eee62/pbthing/out/sim/render/final_s30_events_all_steps.png

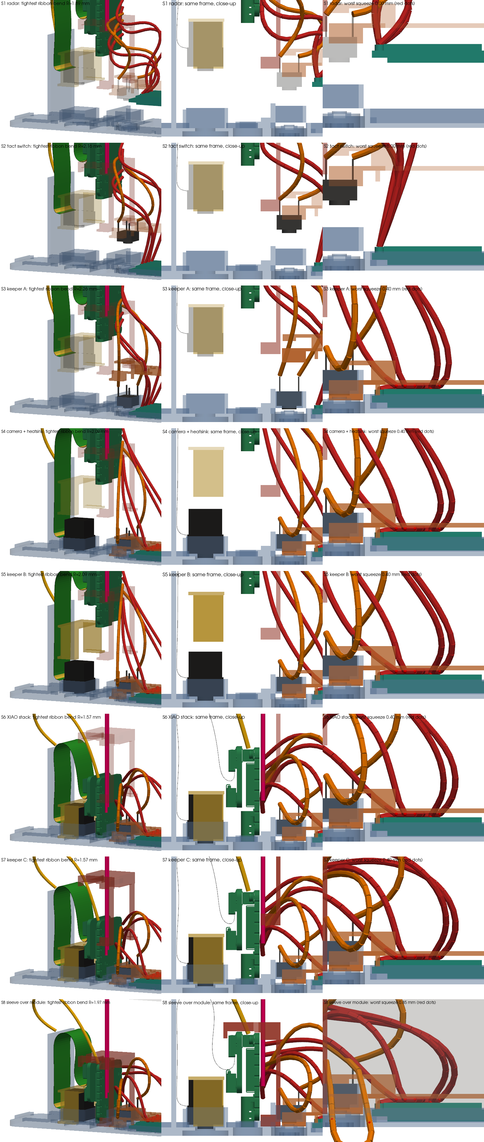
out/sim/render/final_s30_events_all_steps.png
