eee62/pbthing/out/sim/render/A2_events_all_steps.png

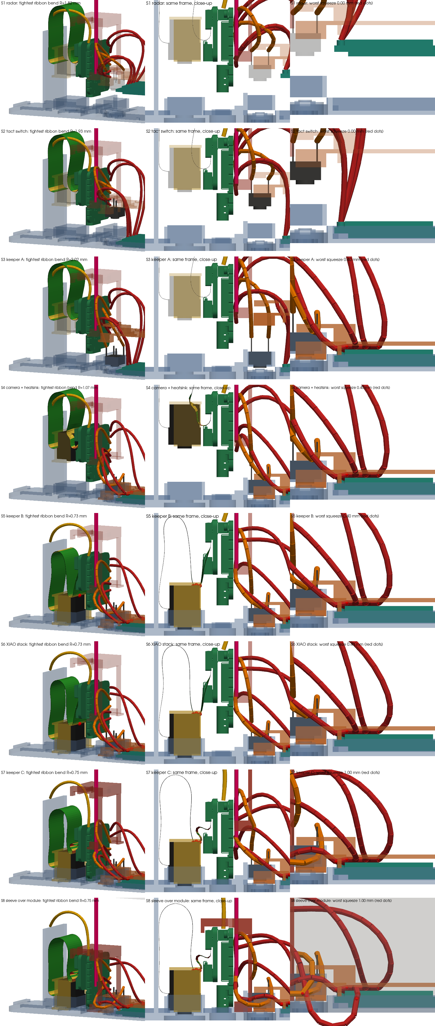
out/sim/render/A2_events_all_steps.png
