eee62/pbthing/out/img/bottom.png

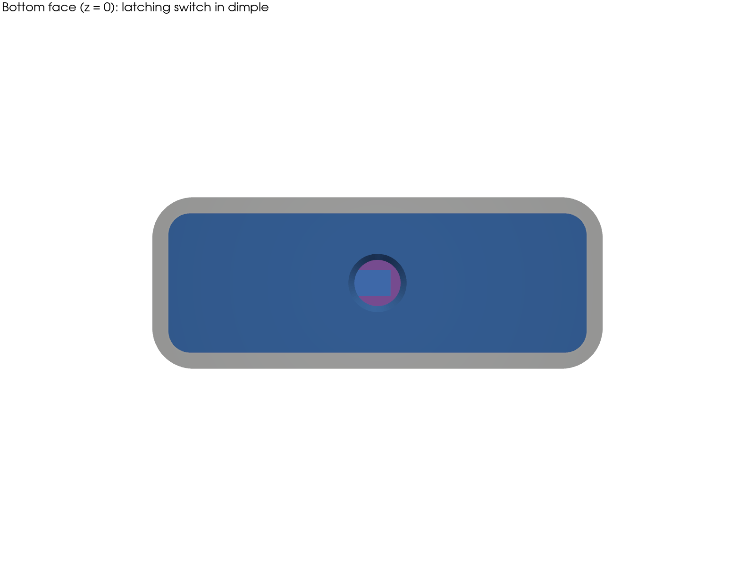
out/img/bottom.png
