eee62/pbthing/out/img/exploded.png

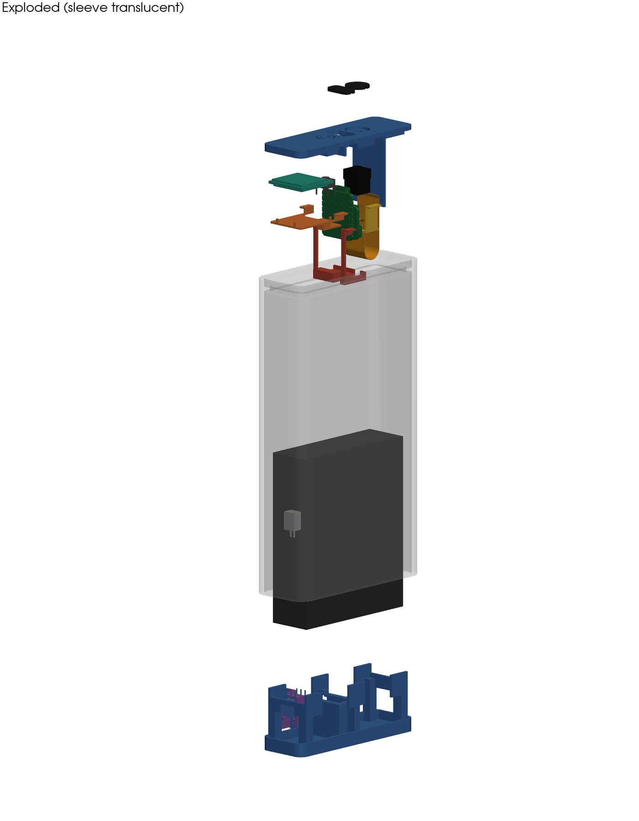
out/img/exploded.png
