eee62/pbthing/out/img/front.png

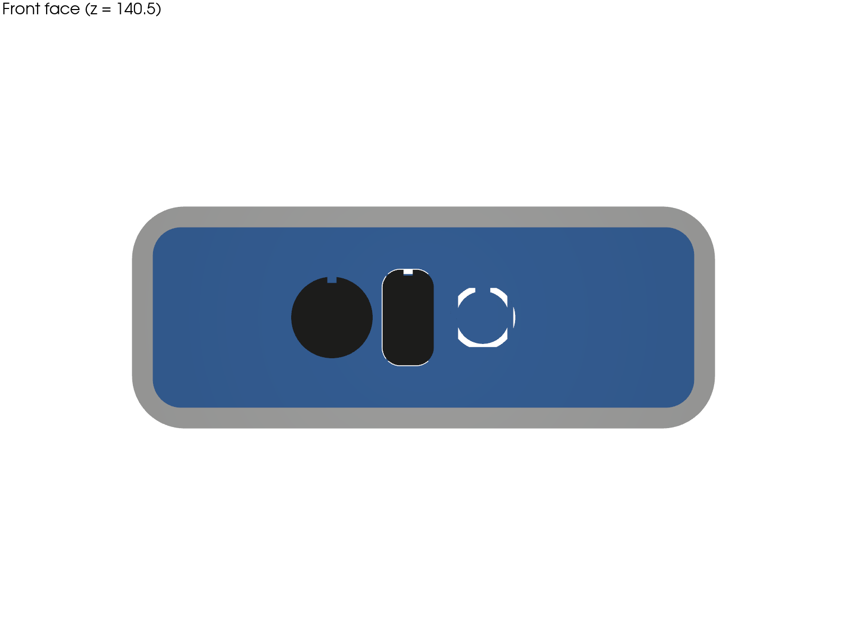
out/img/front.png
