eee62/pbthing/out/img/front_caps_off.png

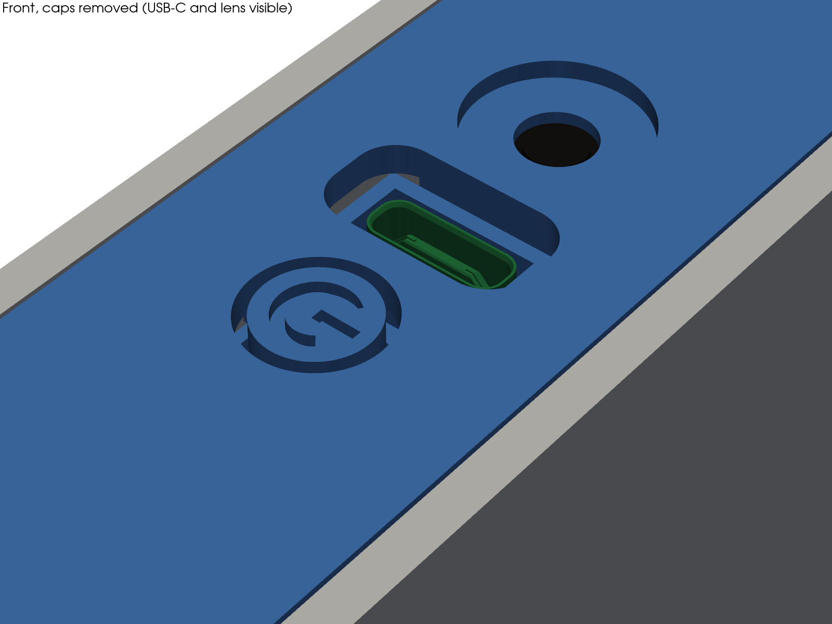
out/img/front_caps_off.png
