eee62/pbthing/out/img/insert_from_below.png

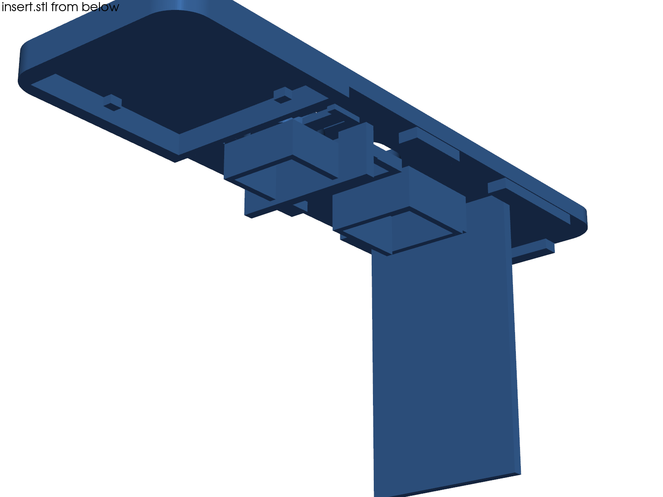
out/img/insert_from_below.png
