eee62/pbthing/out/img/section_full_x14.7.png

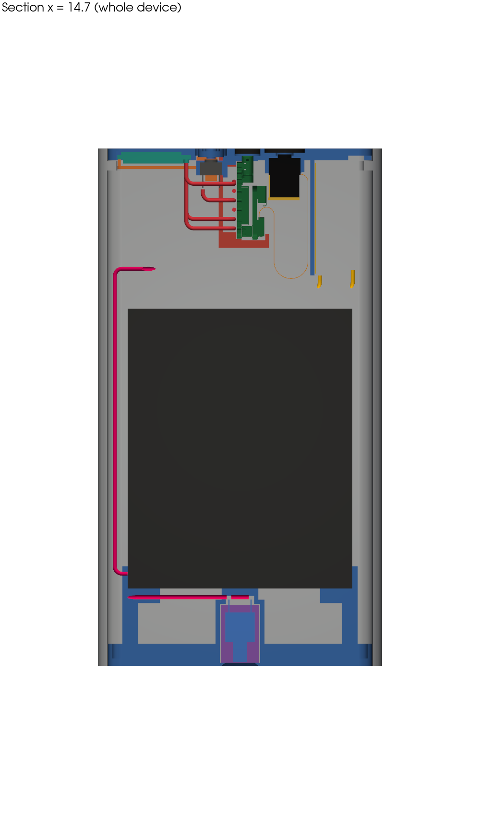
out/img/section_full_x14.7.png
