eee62/pbthing/out/img/section_top_x14.7.png

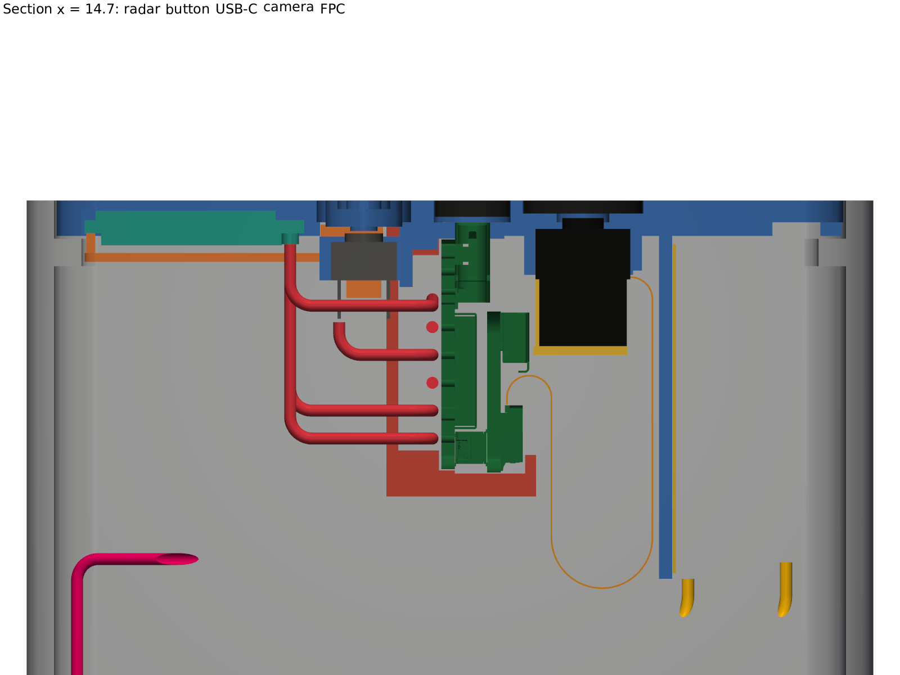
out/img/section_top_x14.7.png
