eee62/pbthing/out/img/section_y38.6_switch.png

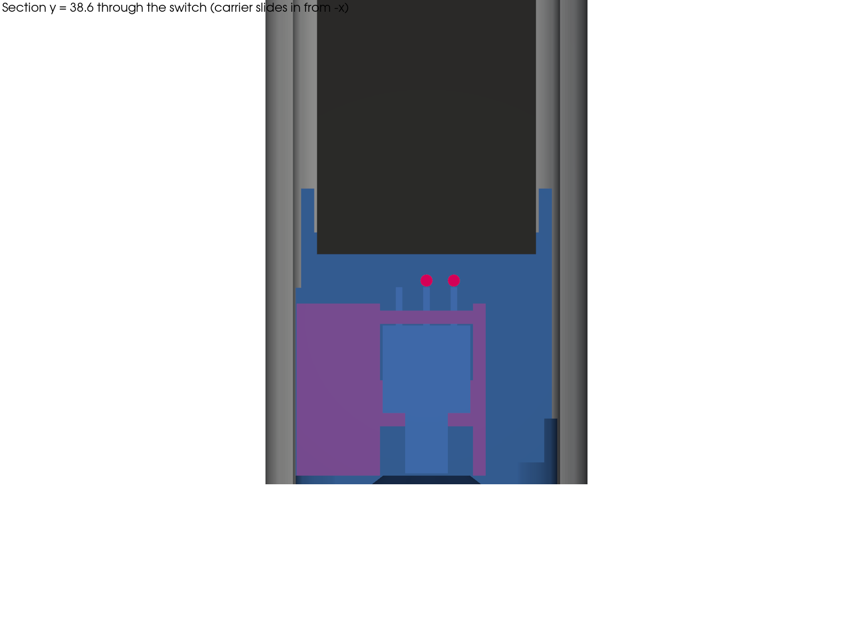
out/img/section_y38.6_switch.png
