eee62/pbthing/out/img/wires_all.png

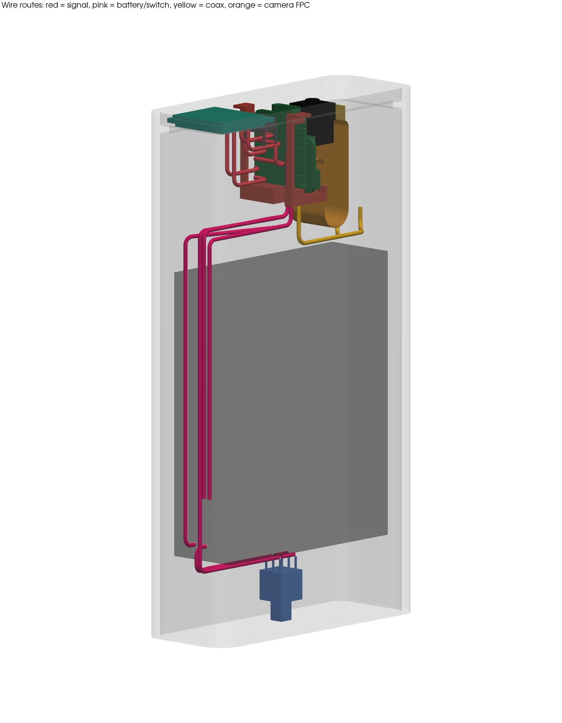
out/img/wires_all.png
