eee62/pbthing/out/img/wires_top.png

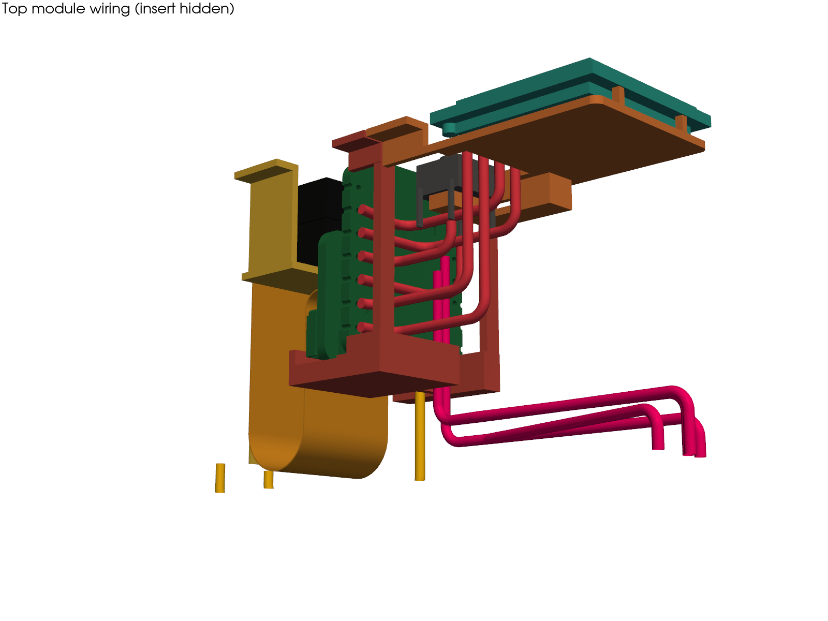
out/img/wires_top.png
