eee62/pbthing/out/img/wires_top_side.png

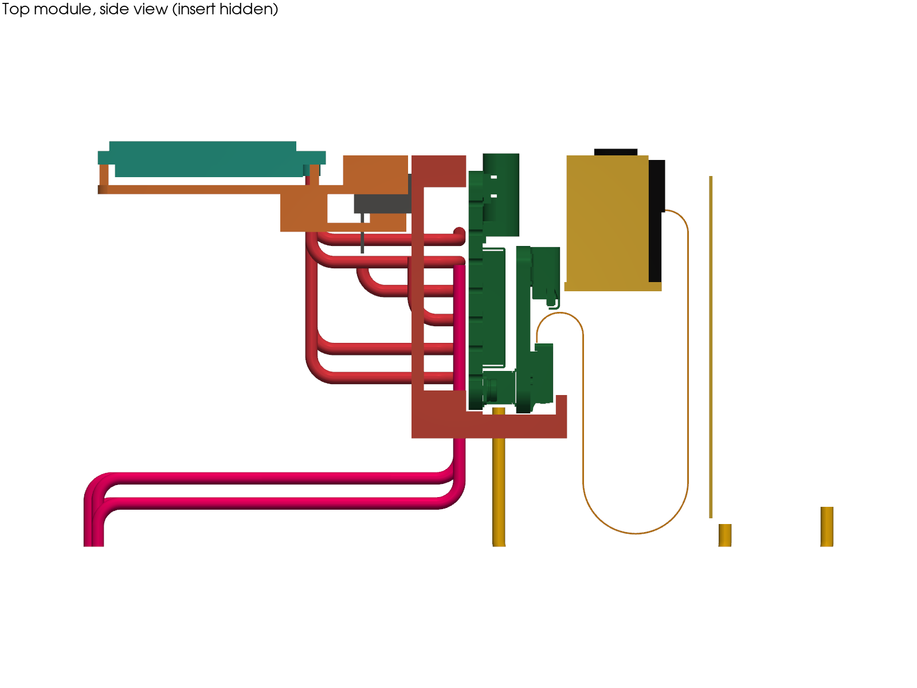
out/img/wires_top_side.png
