eee62/pbthing/out/sim/render/A2_S2_tact_switch.png

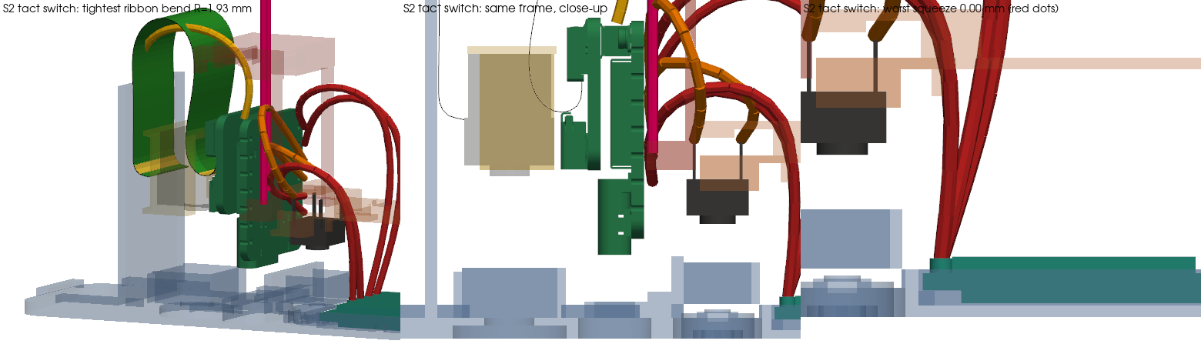
out/sim/render/A2_S2_tact_switch.png
