eee62/pbthing/out/sim/render/A2_S3_keeper_A.png

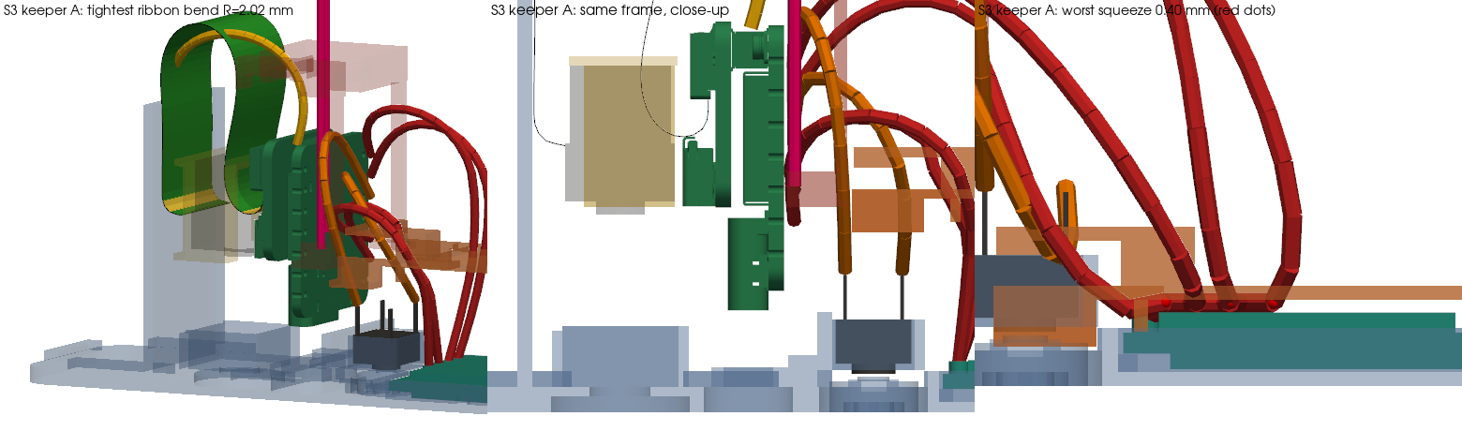
out/sim/render/A2_S3_keeper_A.png
