eee62/pbthing/out/sim/render/A2_S4_camera__heatsink.png

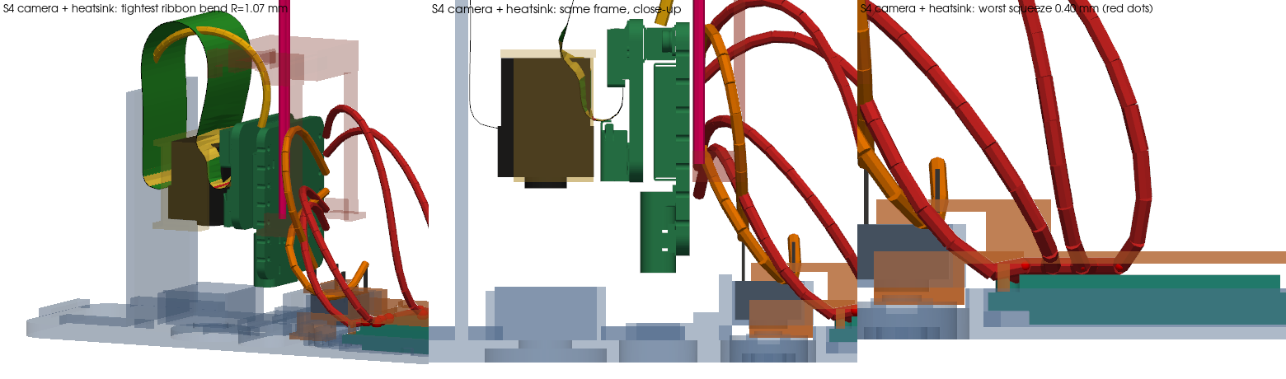
out/sim/render/A2_S4_camera__heatsink.png
