eee62/pbthing/out/sim/render/A2_S5_keeper_B.png

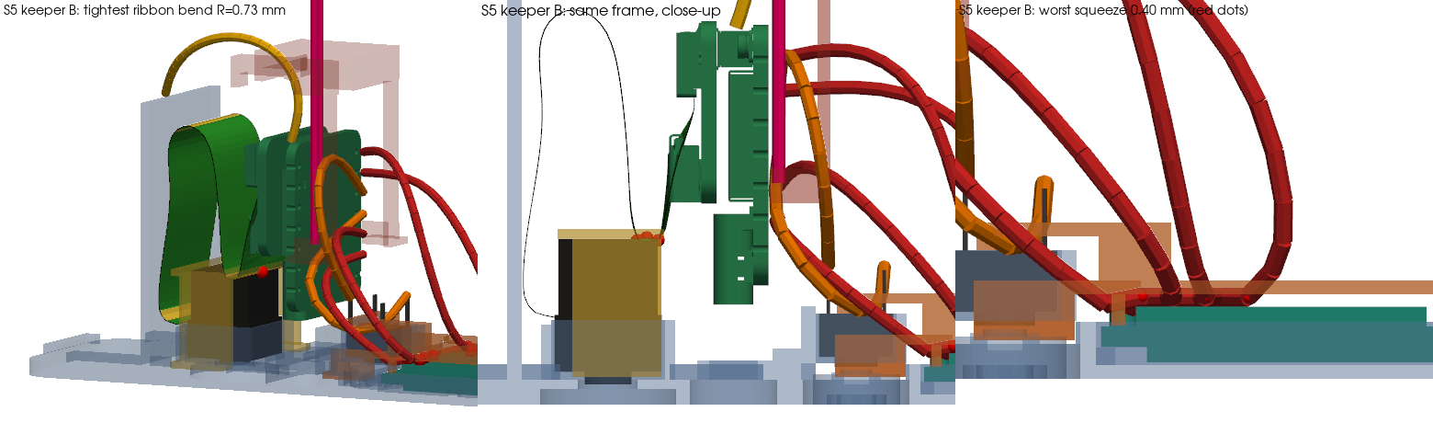
out/sim/render/A2_S5_keeper_B.png
