eee62/pbthing/out/sim/render/A2_S7_keeper_C.png

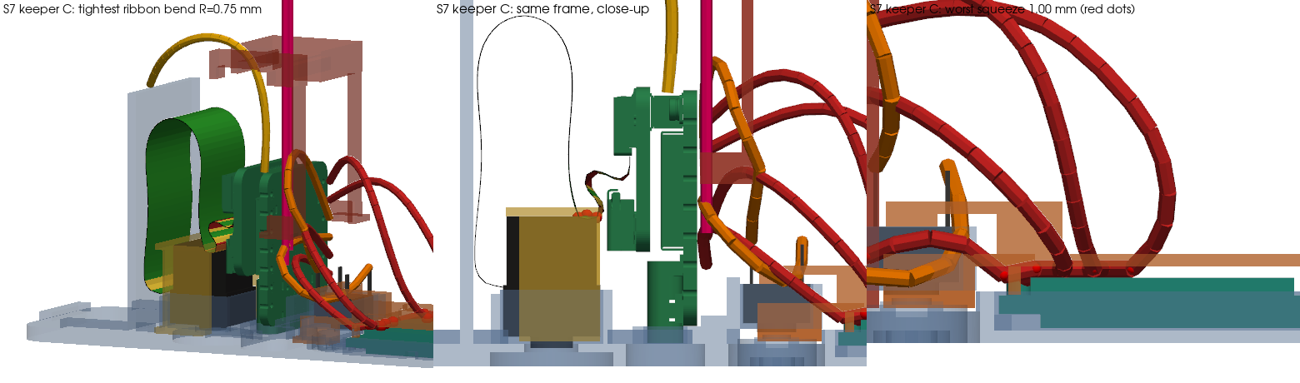
out/sim/render/A2_S7_keeper_C.png
