eee62/pbthing/out/sim/render/A2_S8_sleeve_over_module.png

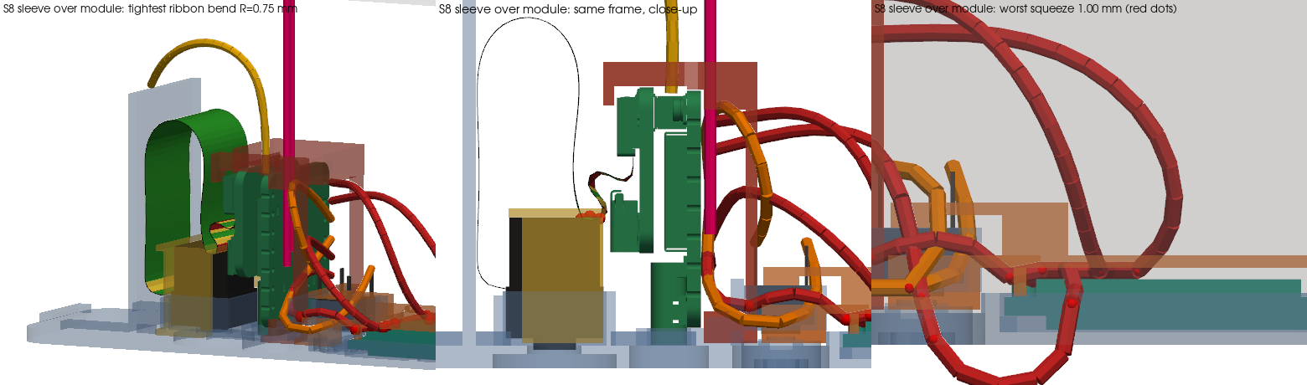
out/sim/render/A2_S8_sleeve_over_module.png
