eee62/pbthing/out/sim/render/fail_hold6_S1_radar.png

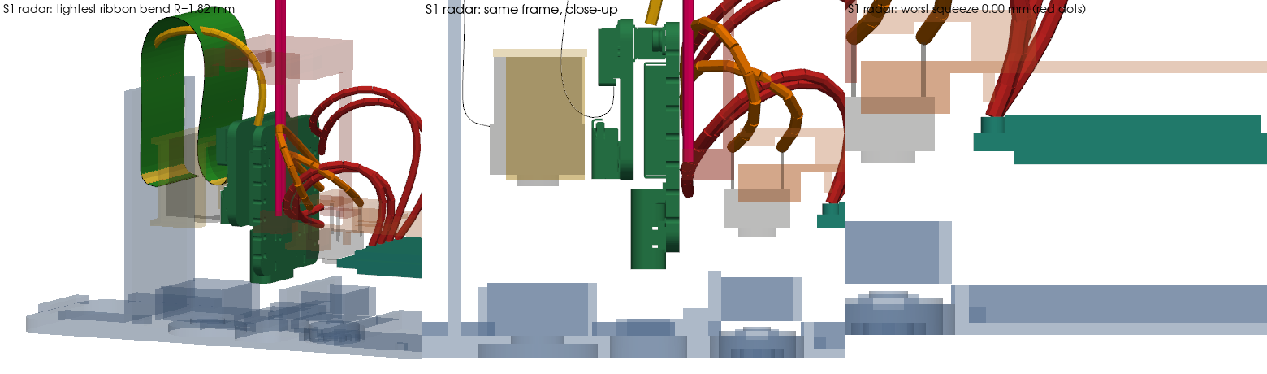
out/sim/render/fail_hold6_S1_radar.png
