eee62/pbthing/out/sim/render/fail_hold6_S3_keeper_A.png

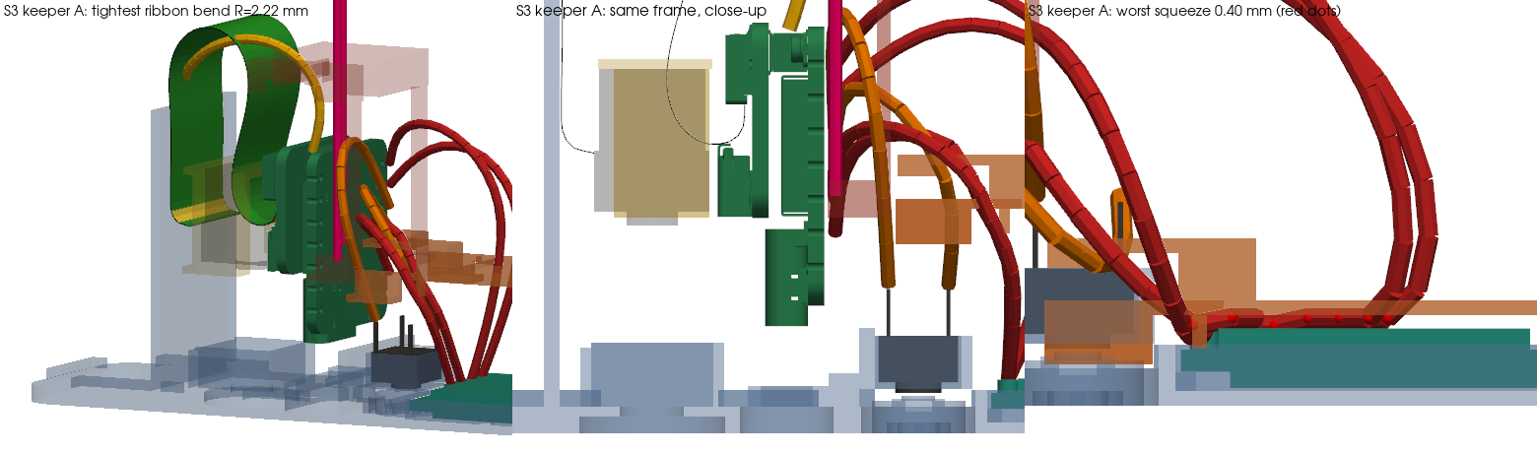
out/sim/render/fail_hold6_S3_keeper_A.png
