eee62/pbthing/out/sim/render/fail_hold6_S4_camera__heatsink.png

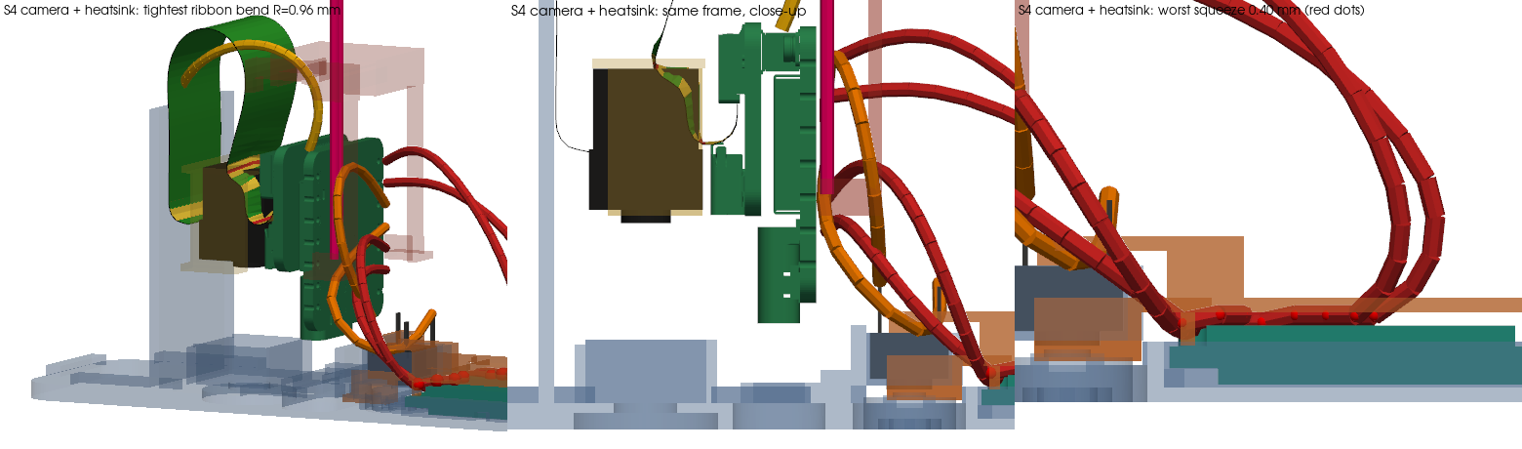
out/sim/render/fail_hold6_S4_camera__heatsink.png
