eee62/pbthing/out/sim/render/fail_hold6_S7_keeper_C.png

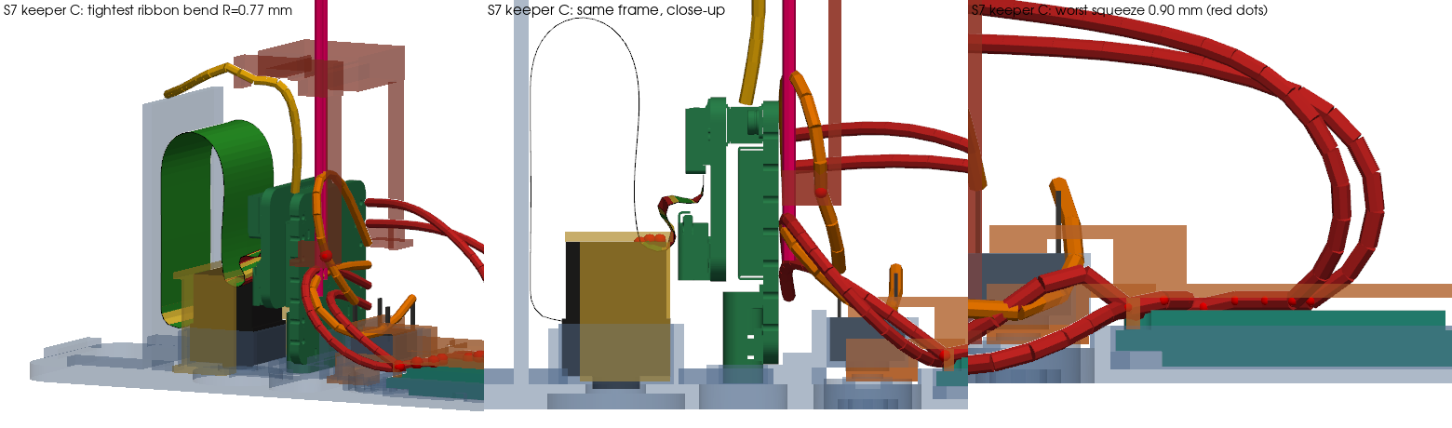
out/sim/render/fail_hold6_S7_keeper_C.png
