eee62/pbthing/out/sim/render/final_dress_S1_radar.png

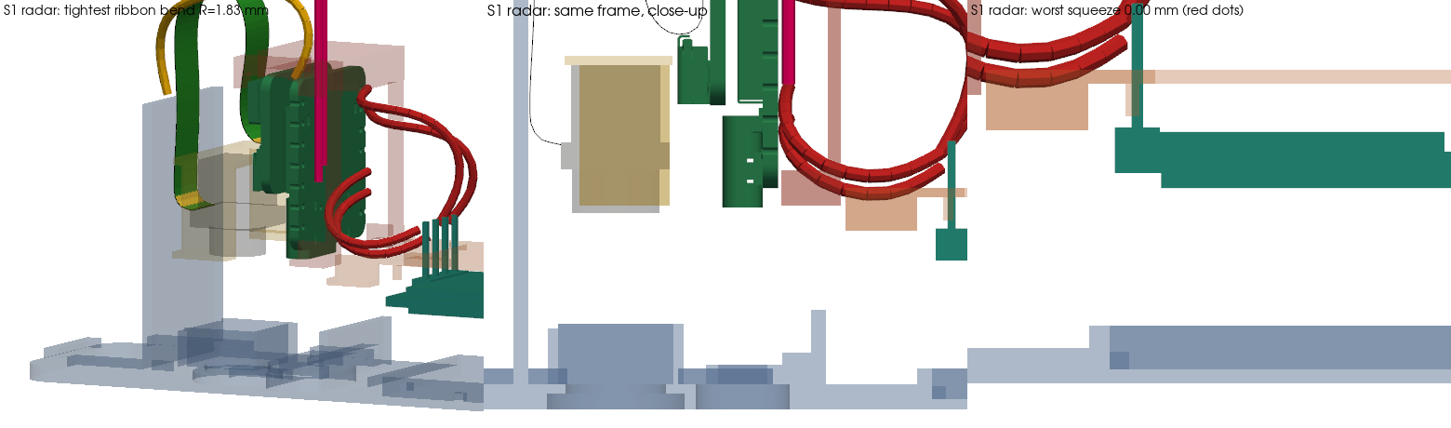
out/sim/render/final_dress_S1_radar.png
