eee62/pbthing/out/sim/render/final_dress_S2_tact_switch.png

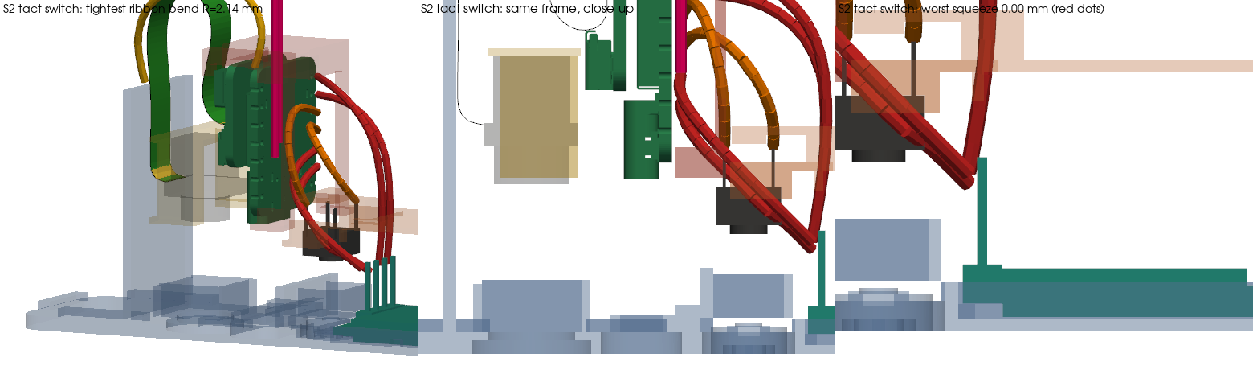
out/sim/render/final_dress_S2_tact_switch.png
