eee62/pbthing/out/sim/render/final_dress_S3_keeper_A.png

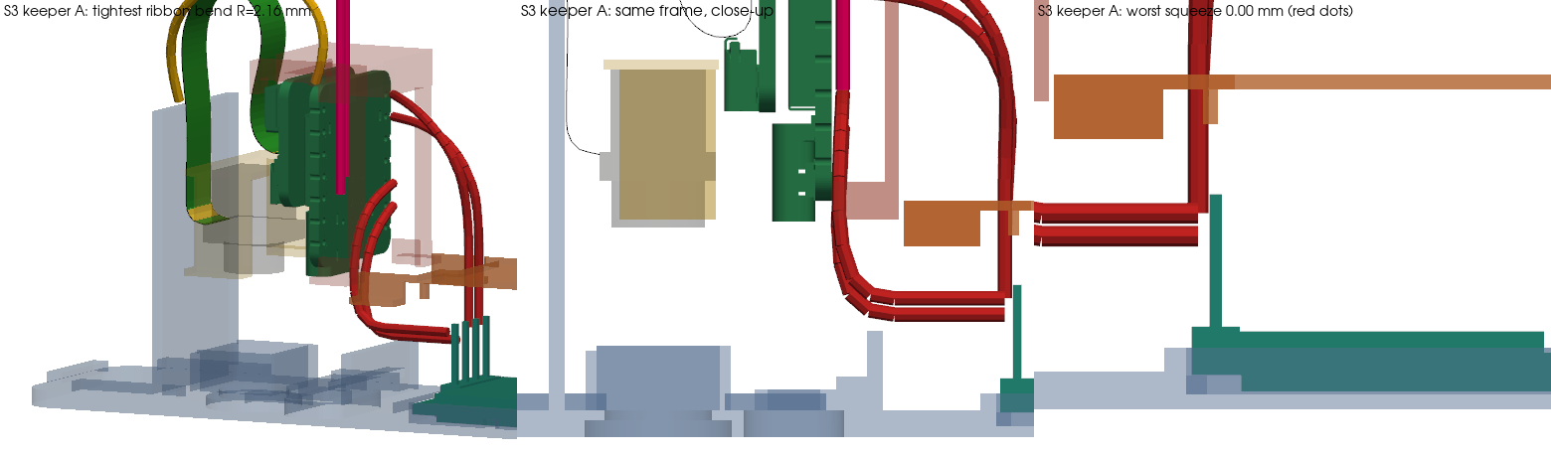
out/sim/render/final_dress_S3_keeper_A.png
