eee62/pbthing/out/sim/render/final_dress_S4_camera__heatsink.png

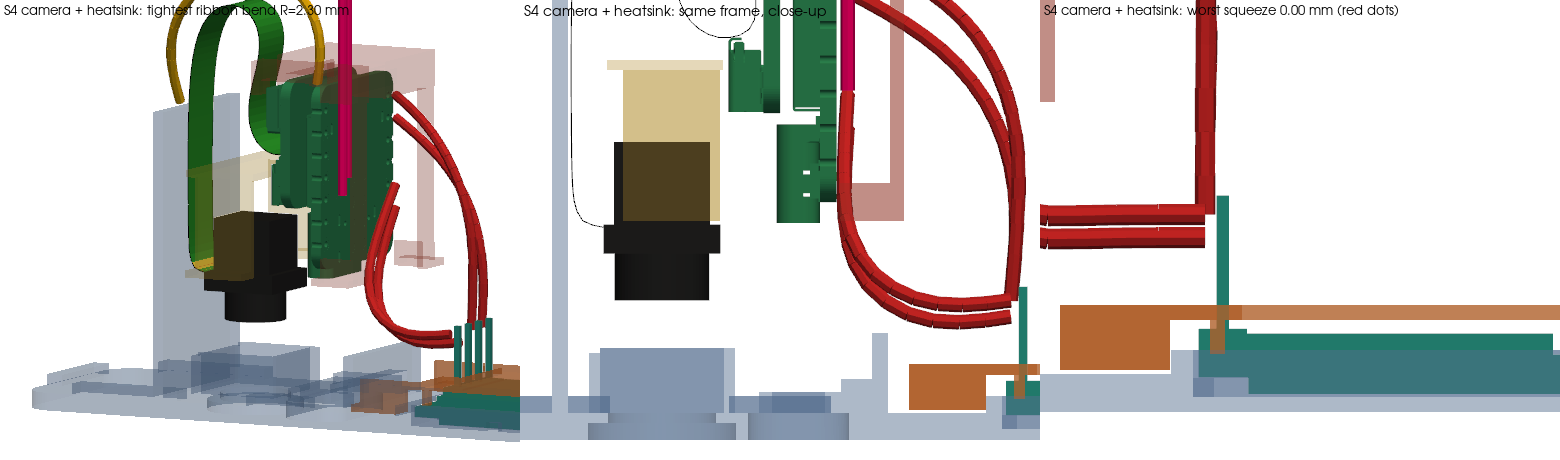
out/sim/render/final_dress_S4_camera__heatsink.png
