eee62/pbthing/out/sim/render/final_dress_S5_keeper_B.png

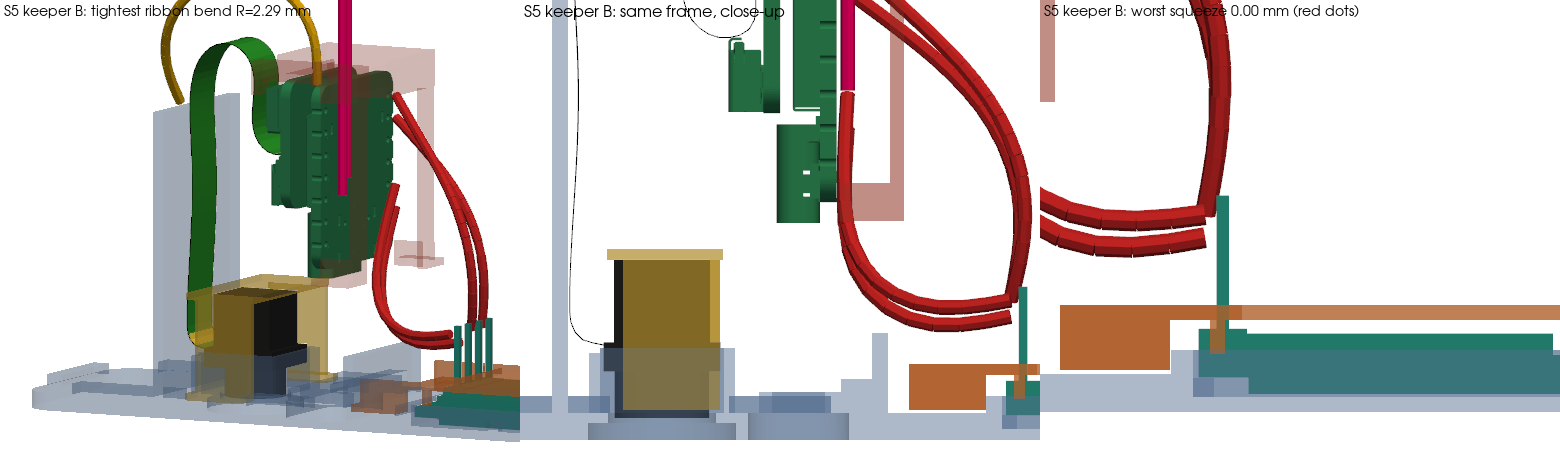
out/sim/render/final_dress_S5_keeper_B.png
