eee62/pbthing/out/sim/render/final_dress_S6_XIAO_stack.png

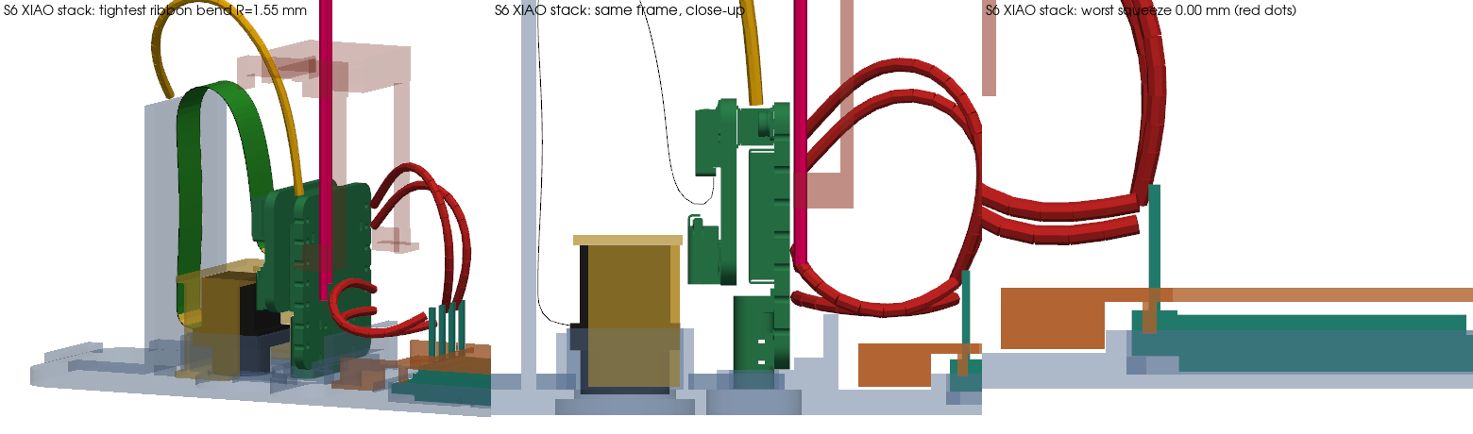
out/sim/render/final_dress_S6_XIAO_stack.png
