eee62/pbthing/out/sim/render/final_s30_S1_radar.png

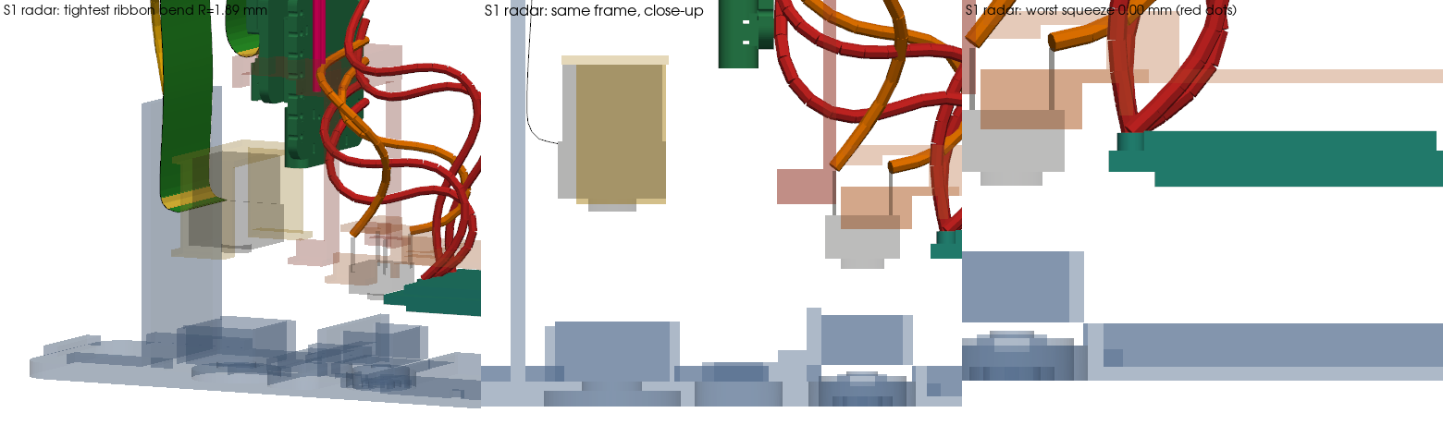
out/sim/render/final_s30_S1_radar.png
