eee62/pbthing/out/sim/render/final_s30_S3_keeper_A.png

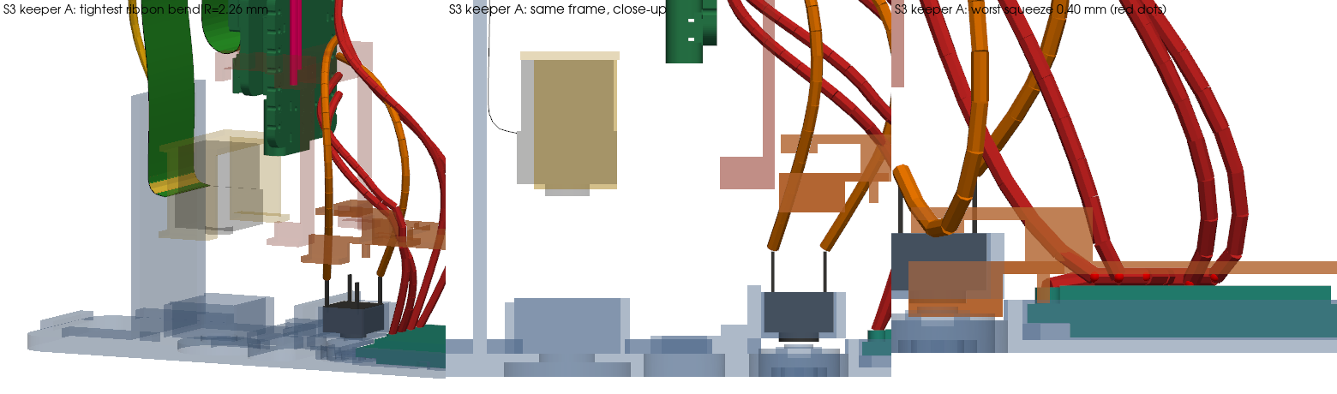
out/sim/render/final_s30_S3_keeper_A.png
