eee62/pbthing/out/sim/render/final_s30_S4_camera__heatsink.png

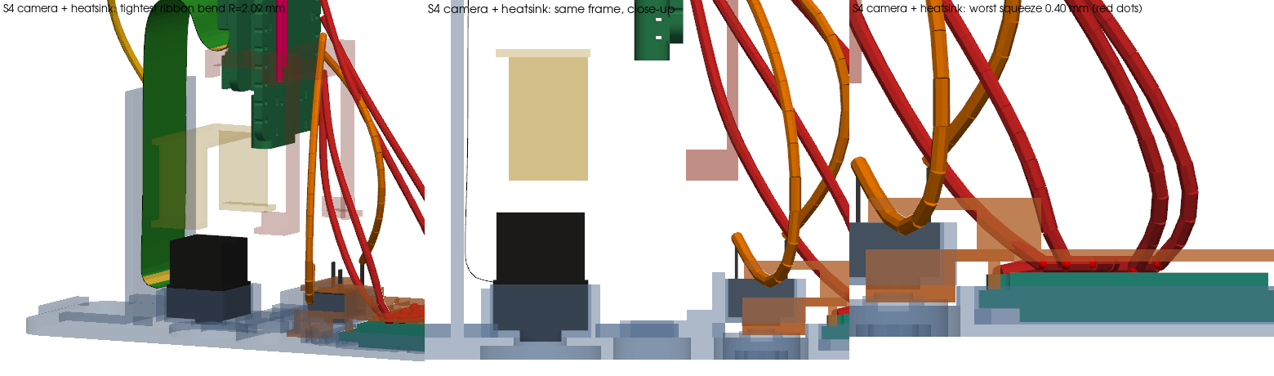
out/sim/render/final_s30_S4_camera__heatsink.png
