eee62/pbthing/out/sim/render/final_s30_S7_keeper_C.png

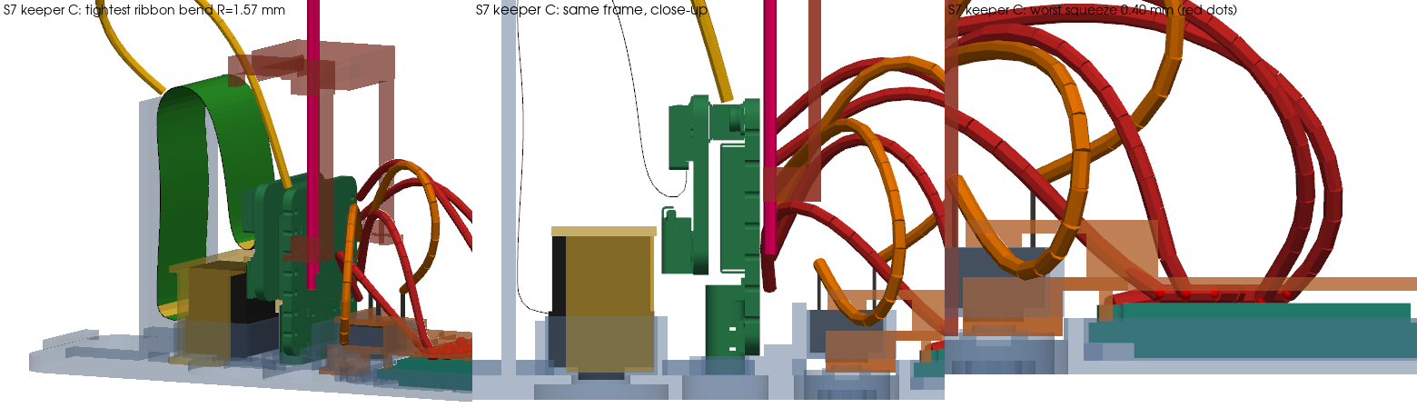
out/sim/render/final_s30_S7_keeper_C.png
