eee62/pbthing/out/sim/render/final_s30_S8_sleeve_over_module.png

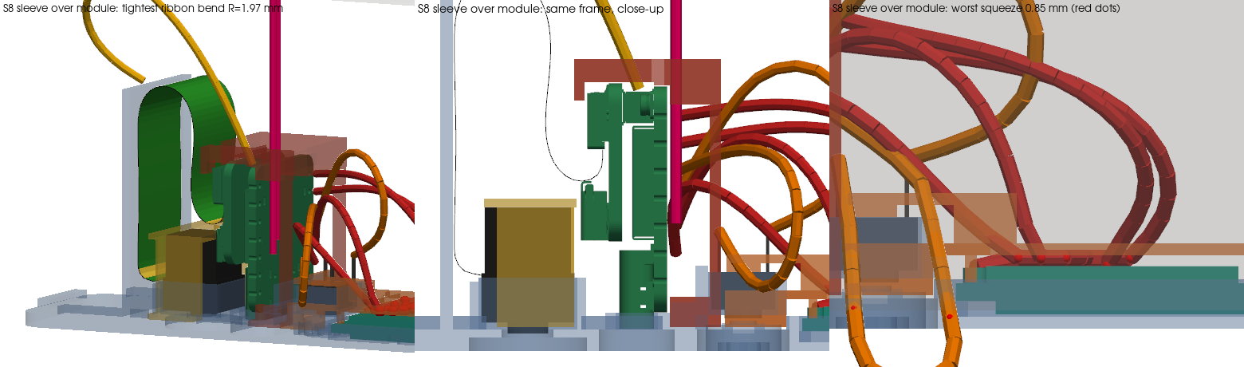
out/sim/render/final_s30_S8_sleeve_over_module.png
