eee62/pbthing/out/sim/render/radar_all_cases.png

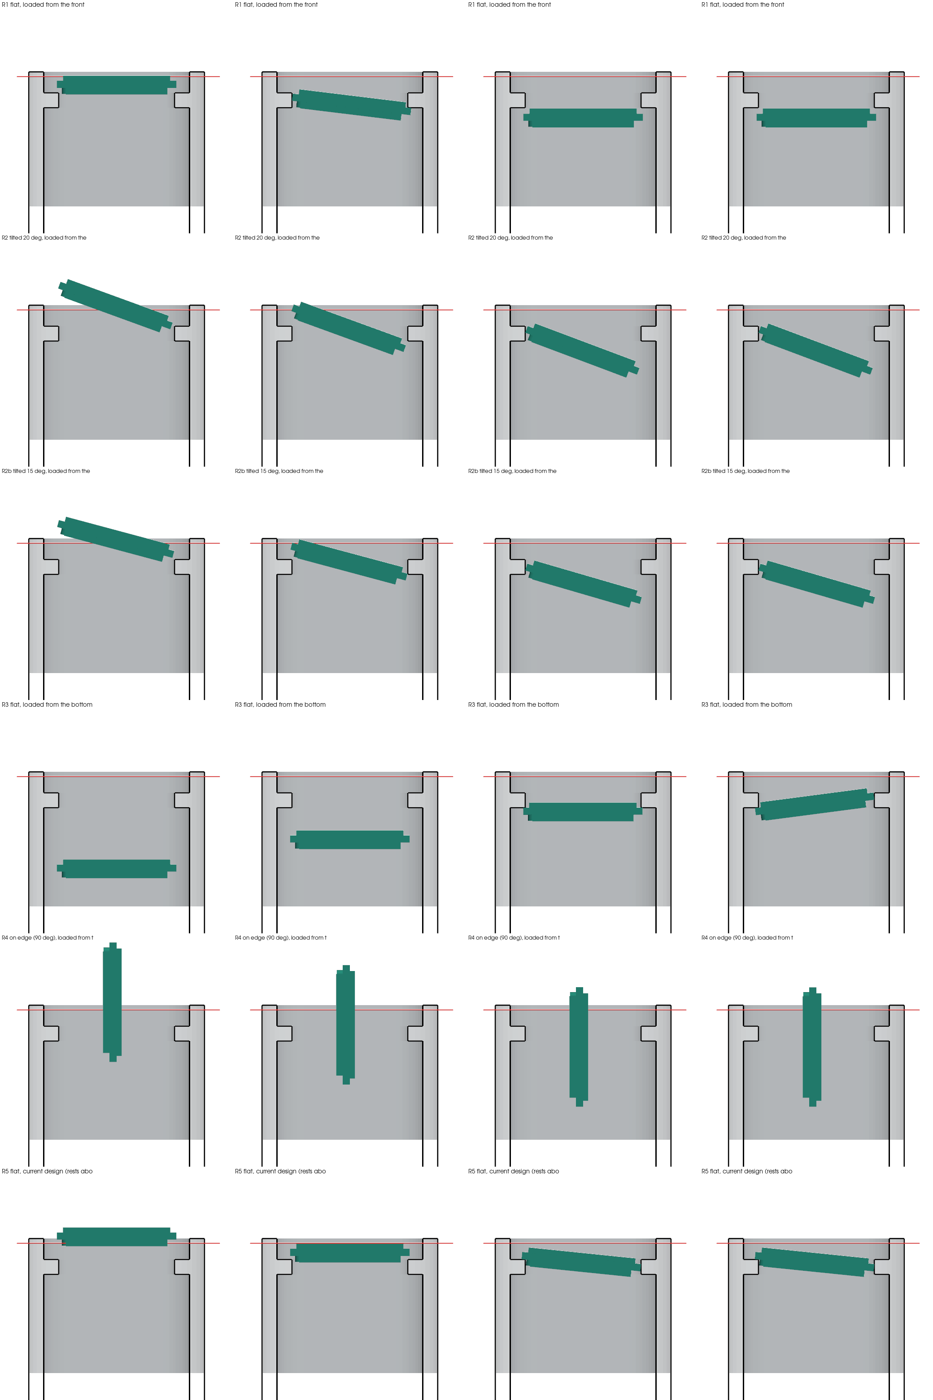
out/sim/render/radar_all_cases.png
