eee62/pbthing/out/sim/render/radar_R1.png

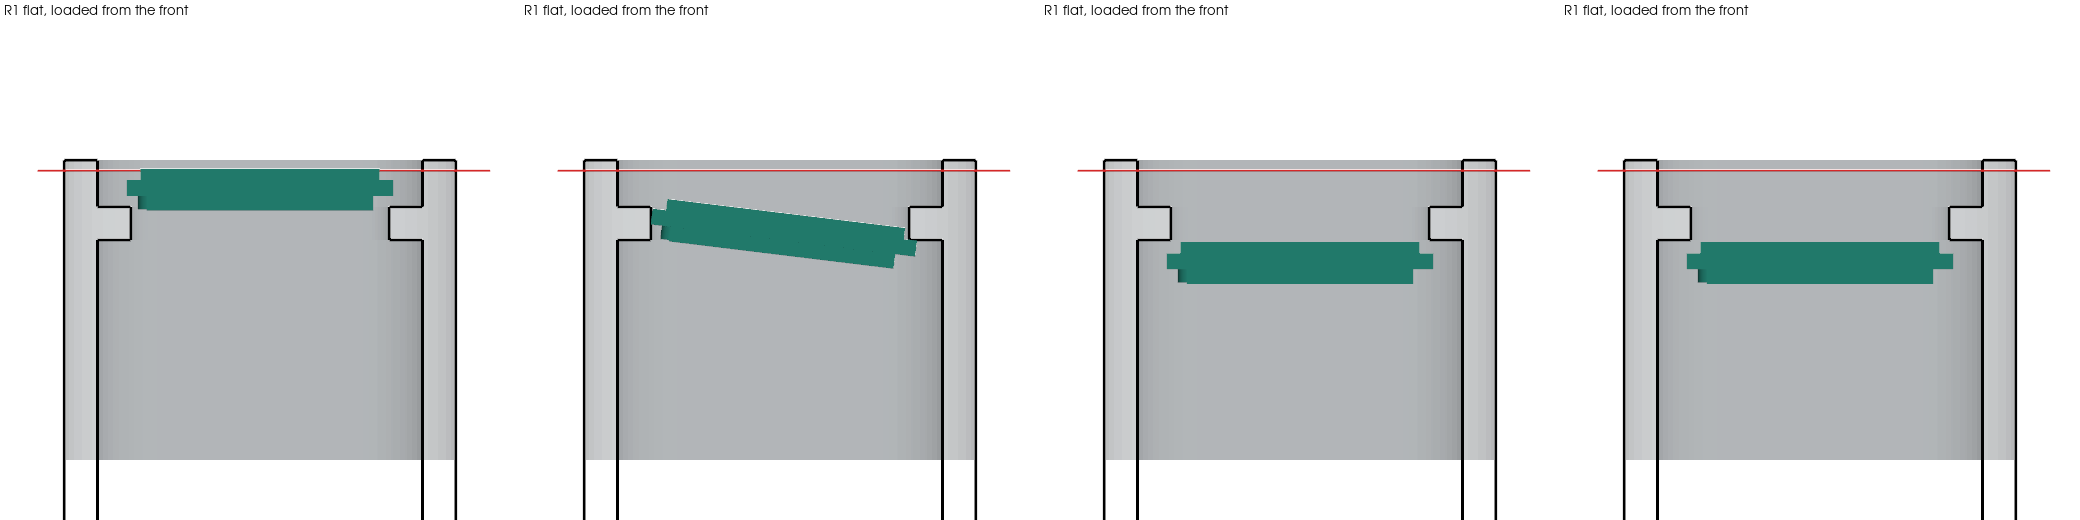
out/sim/render/radar_R1.png
