eee62/pbthing/out/sim/render/radar_R4.png

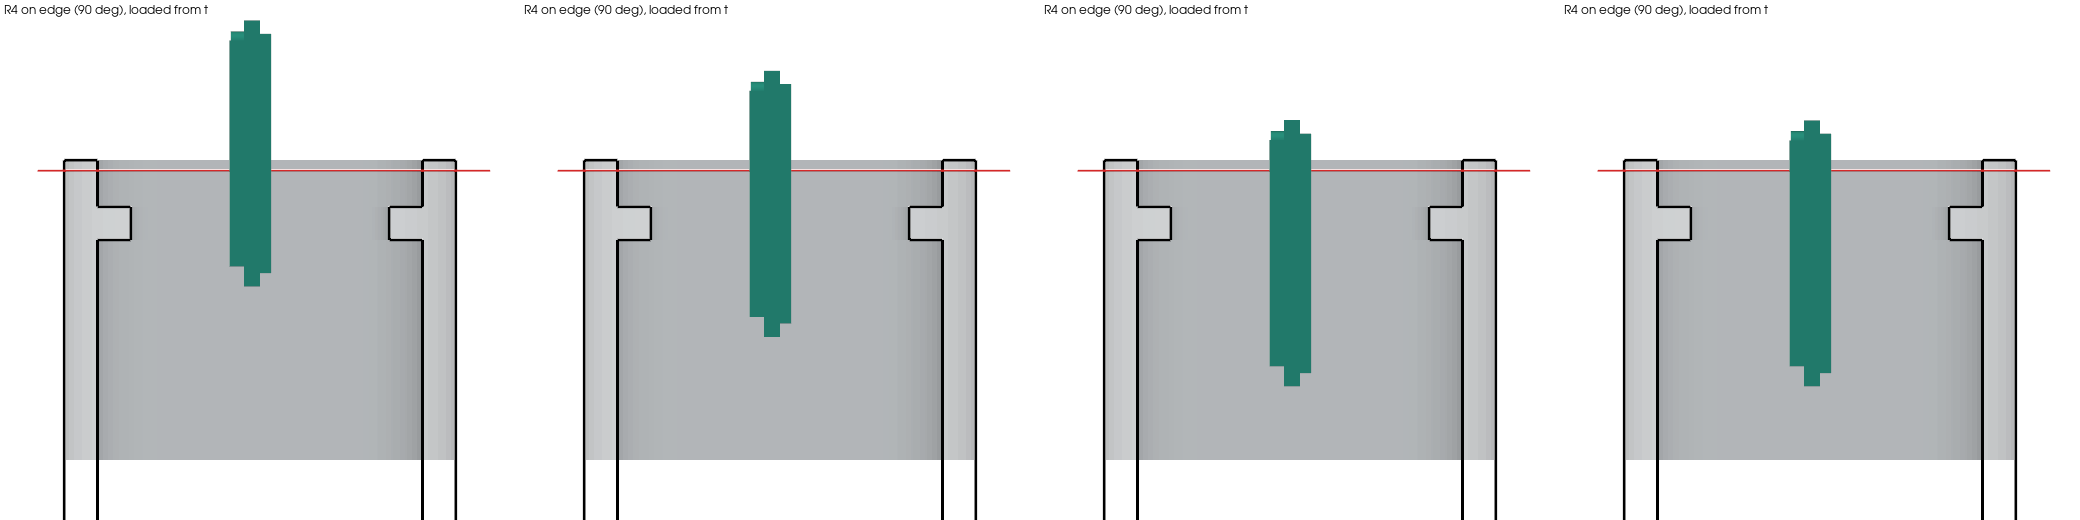
out/sim/render/radar_R4.png
