eee62/pbthing/inputs/XIAO_ESP32S3_ExpBoard_v1.0_bot.dxf

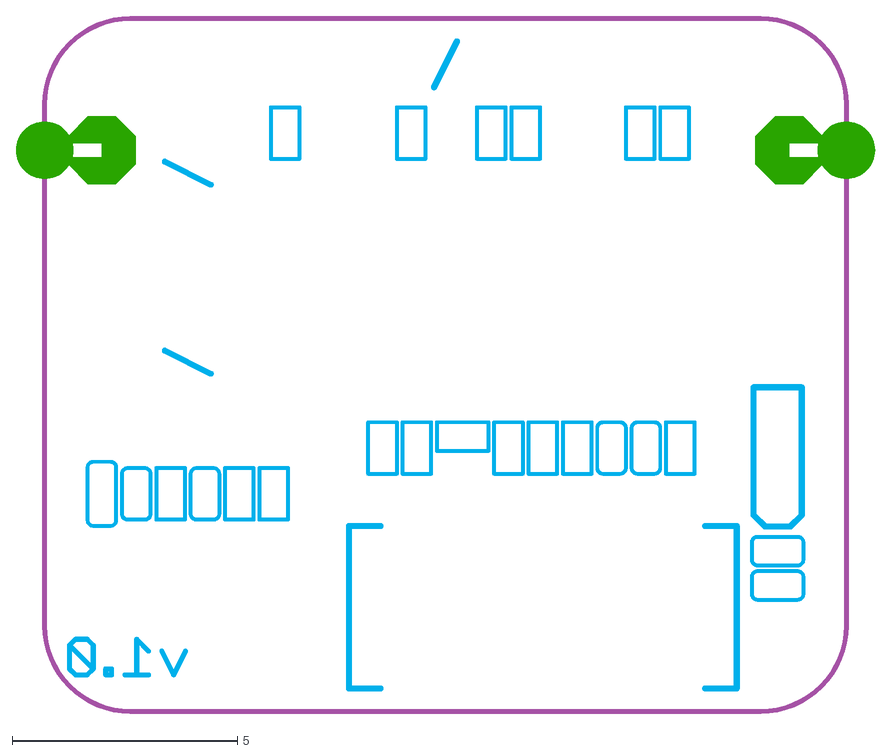
[picture p41: CAD file, 2026-11-05]
inputs/XIAO_ESP32S3_ExpBoard_v1.0_bot.dxf
19.0 x 15.5
