eee62/pbthing/out/step/keeper_c.step

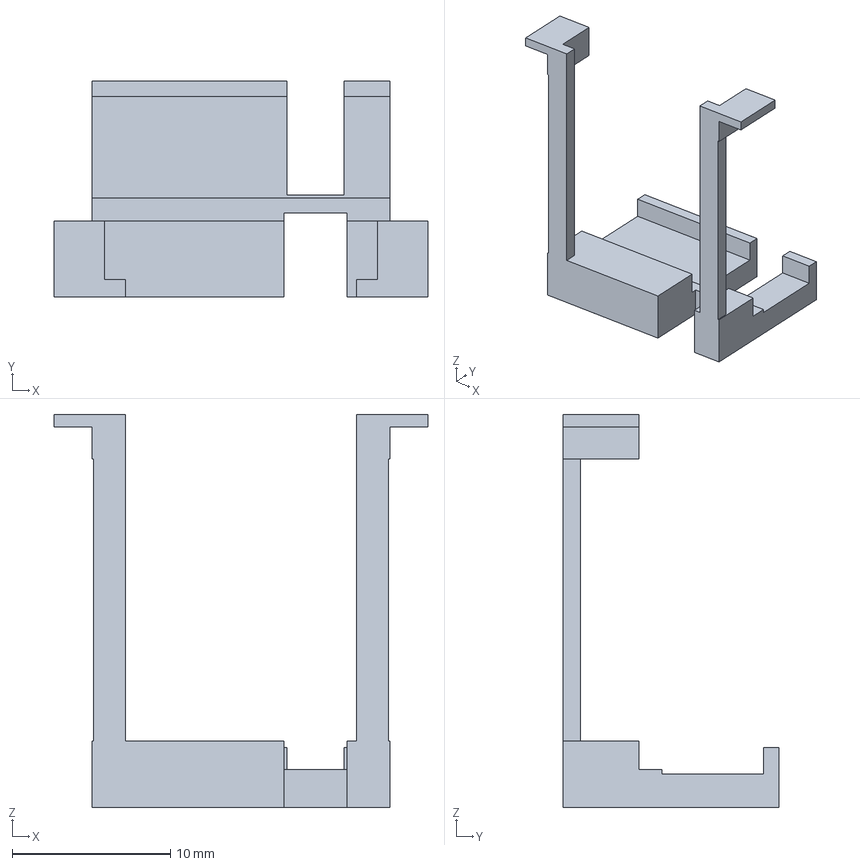
[picture p42: CAD file, 2026-11-08]
out/step/keeper_c.step
23.6 x 13.7 x 24.8 mm
