eee62/pbthing/out/stl/coupon.stl

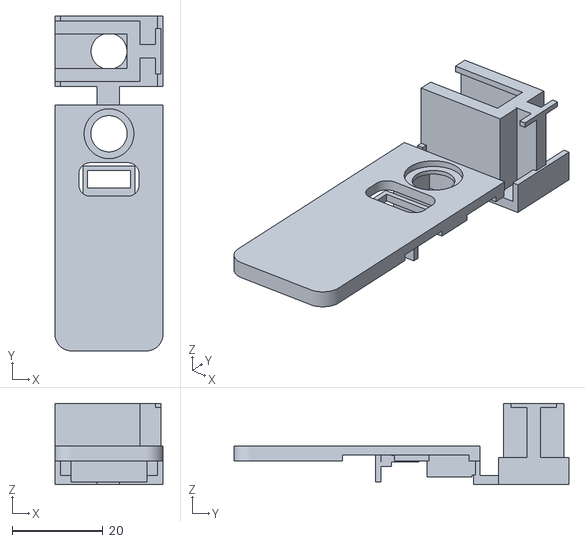
[picture p43: CAD file, 2026-11-08]
out/stl/coupon.stl
23.9 x 74.0 x 18.0
