eee62/pbthing/out/stl/tray_parts/keeper_a.stl

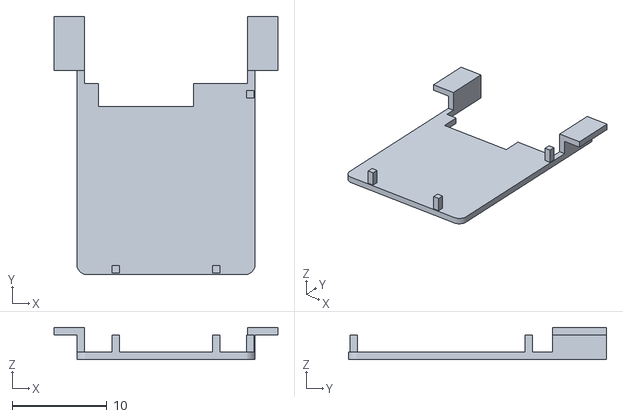
[picture p44: CAD file, 2026-11-08]
out/stl/tray_parts/keeper_a.stl
23.6 x 27.2 x 3.40
