eee62/pbthing/inputs/zen_v7_sleeve.stl

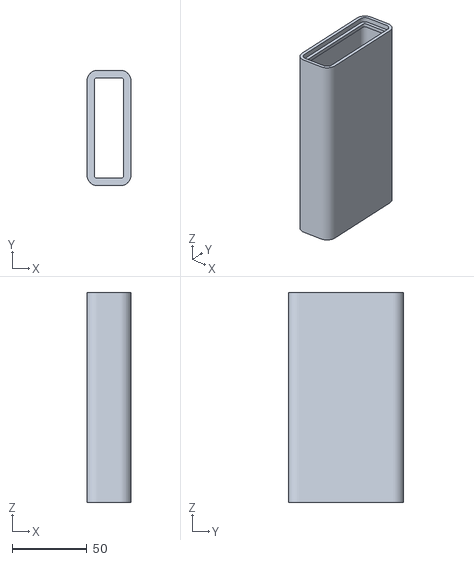
[picture p45: CAD file, 2026-11-05]
inputs/zen_v7_sleeve.stl
29.4 x 77.2 x 140.5
