eee62/pbthing/out/stl/tray.stl

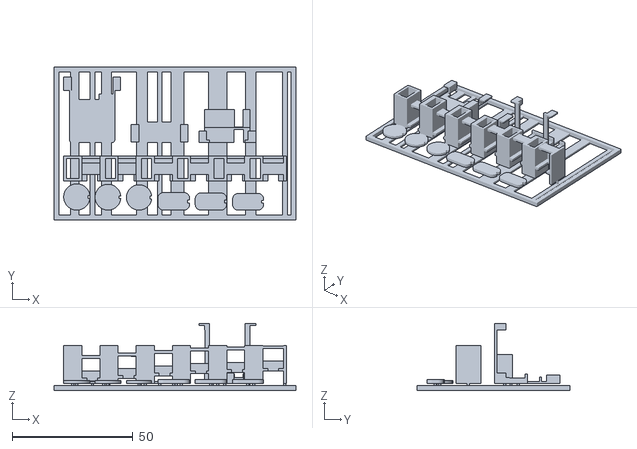
[picture p46: CAD file, 2026-11-08]
out/stl/tray.stl
100.2 x 63.2 x 27.8
