eee62/pbthing/out/stl/tray_parts/usb_cover_C.stl

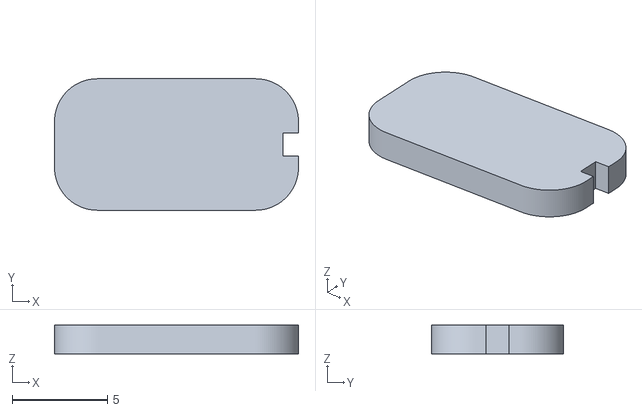
[picture p47: CAD file, 2026-11-07]
out/stl/tray_parts/usb_cover_C.stl
12.8 x 6.90 x 1.50
