eee62/pbthing/inputs/XIAO_ESP32S3_ExpBoard_v1.0_top.dxf

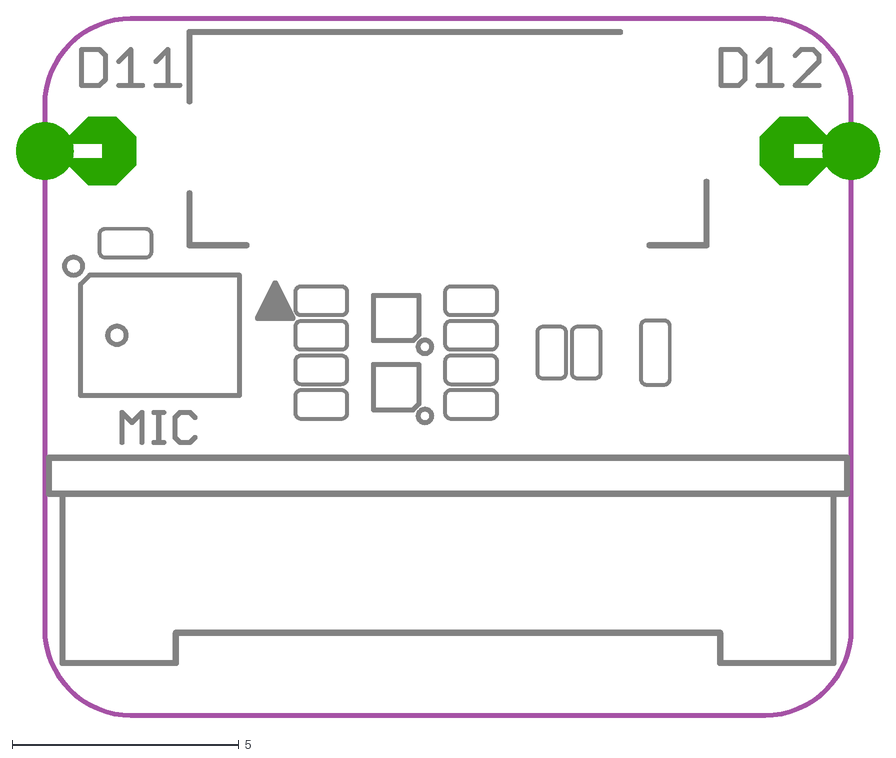
[picture p48: CAD file, 2026-11-05]
inputs/XIAO_ESP32S3_ExpBoard_v1.0_top.dxf
19.0 x 15.5
