eee62/pbthing/out/step/keeper_b.step

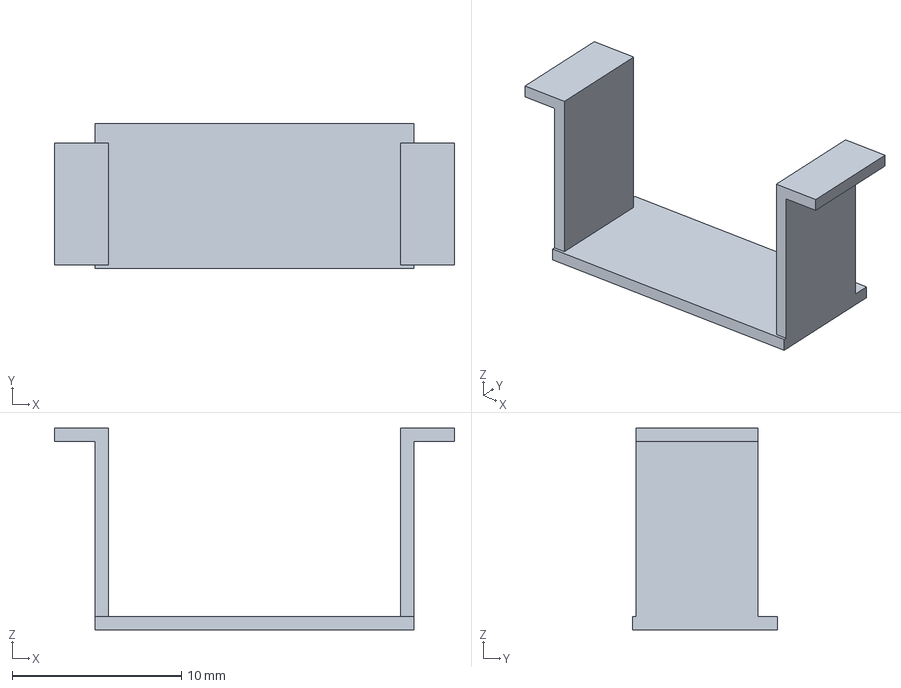
[picture p49: CAD file, 2026-11-08]
out/step/keeper_b.step
23.6 x 8.55 x 11.9 mm
