eee62/pbthing/out/stl/tray_parts/usb_cover_A.stl

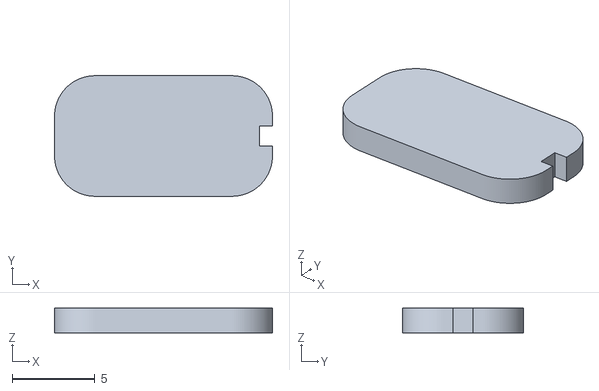
[picture p50: CAD file, 2026-11-07]
out/stl/tray_parts/usb_cover_A.stl
13.2 x 7.30 x 1.50
