eee62/pbthing/out/step/plug.step

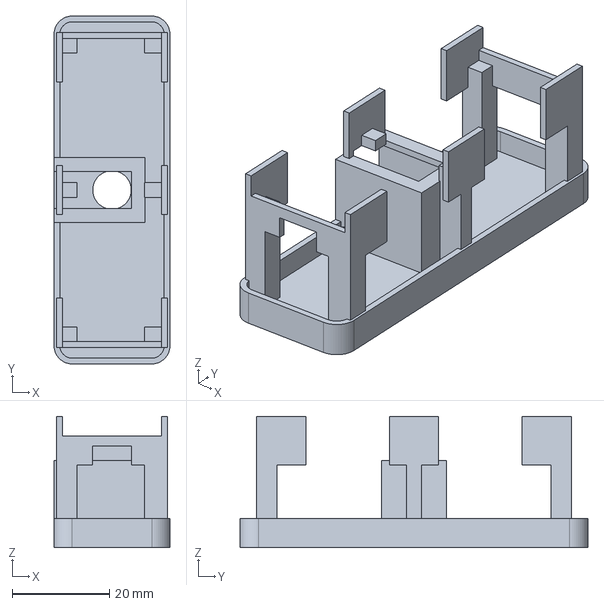
[picture p52: CAD file, 2026-11-08]
out/step/plug.step
23.9 x 71.7 x 27.0 mm
