eee62/pbthing/out/stl/tray_parts/usb_cover_B.stl

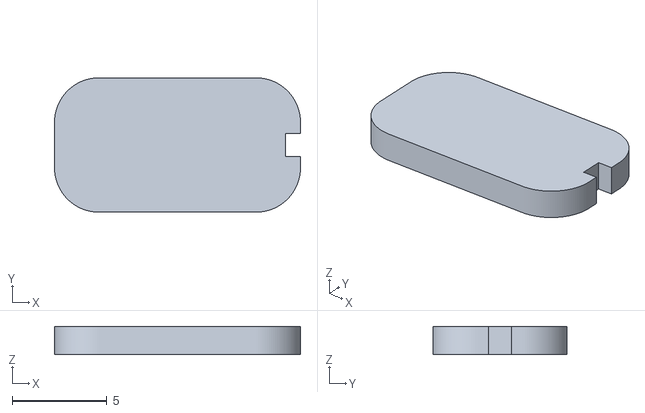
[picture p53: CAD file, 2026-11-07]
out/stl/tray_parts/usb_cover_B.stl
13.0 x 7.10 x 1.50
