eee62/pbthing/out/step/insert.step

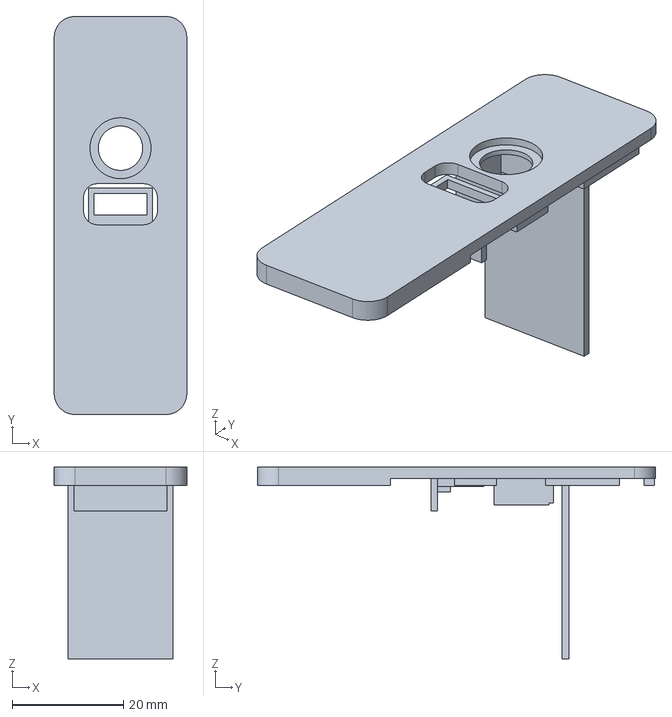
[picture p54: CAD file, 2026-11-08]
out/step/insert.step
23.9 x 71.7 x 34.5 mm
