eee62/pbthing/out/stl/tray_parts/carrier_H10.stl

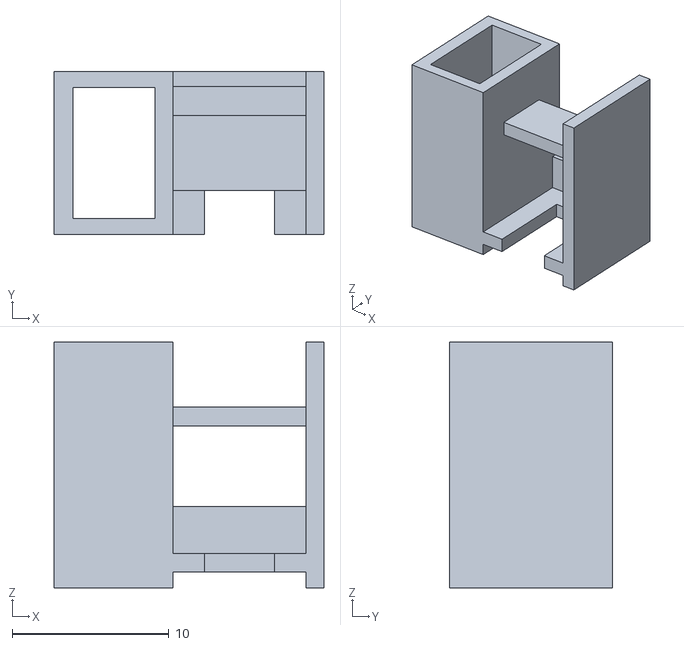
[picture p55: CAD file, 2026-11-05]
out/stl/tray_parts/carrier_H10.stl
17.3 x 10.4 x 15.7
