eee62/pbthing/out/stl/tray_parts/lens_cap_B.stl

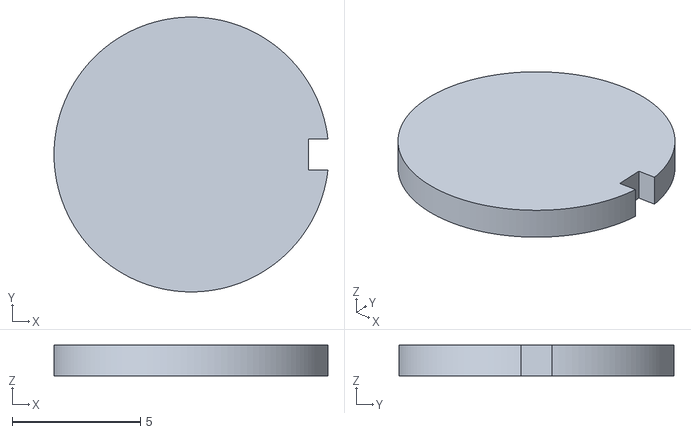
[picture p56: CAD file, 2026-11-05]
out/stl/tray_parts/lens_cap_B.stl
10.7 x 10.7 x 1.20
