eee62/pbthing/out/stl/tray_parts/lens_cap_C.stl

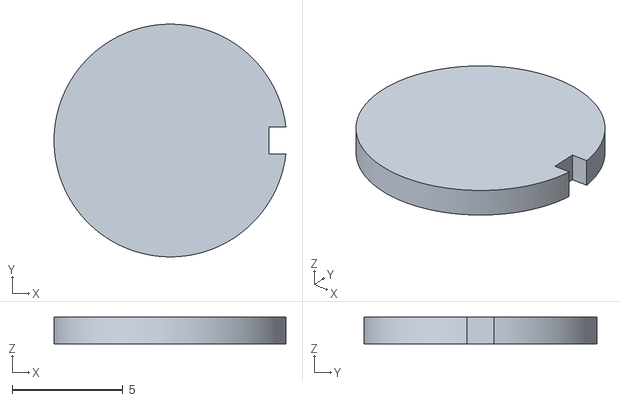
[picture p57: CAD file, 2026-11-05]
out/stl/tray_parts/lens_cap_C.stl
10.5 x 10.5 x 1.20
