eee62/pbthing/out/stl/tray_parts/lens_cap_A.stl

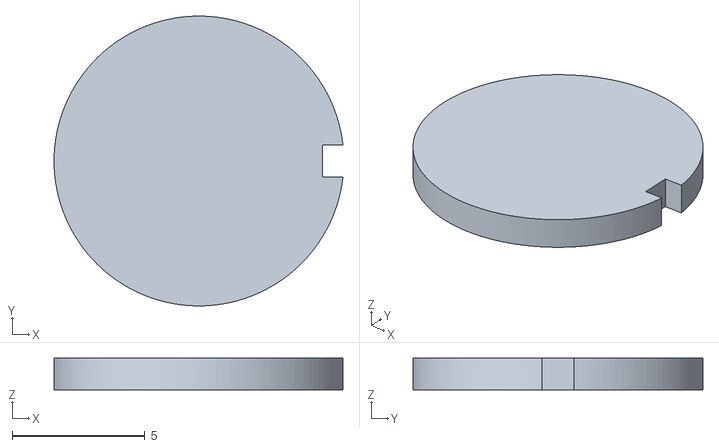
[picture p58: CAD file, 2026-11-05]
out/stl/tray_parts/lens_cap_A.stl
10.9 x 10.9 x 1.20
