eee62/pbthing/(list of files, cad)

Other CAD files:
out/step/keeper_a.step
out/stl/tray_parts/keeper_b.stl
out/stl/tray_parts/carrier_H12.stl
out/stl/tray_parts/carrier_H14.stl
out/stl/tray_parts/carrier_H13.5.stl
out/stl/tray_parts/keeper_c.stl
out/stl/tray_parts/carrier_H11.stl
out/stl/tray_parts/carrier_H13.stl
out/stl/insert.stl
out/stl/plug.stl
