eee62/pbthing/out/img/print_coupon.png

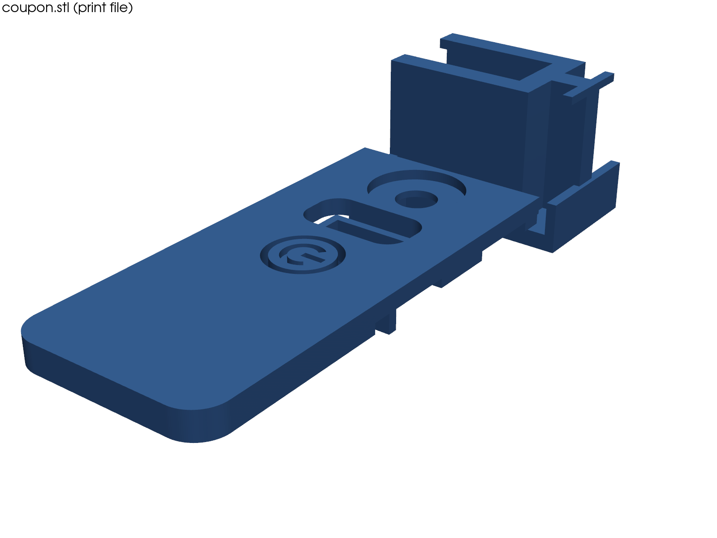
out/img/print_coupon.png
