eee62/pbthing/out/img/print_tray.png

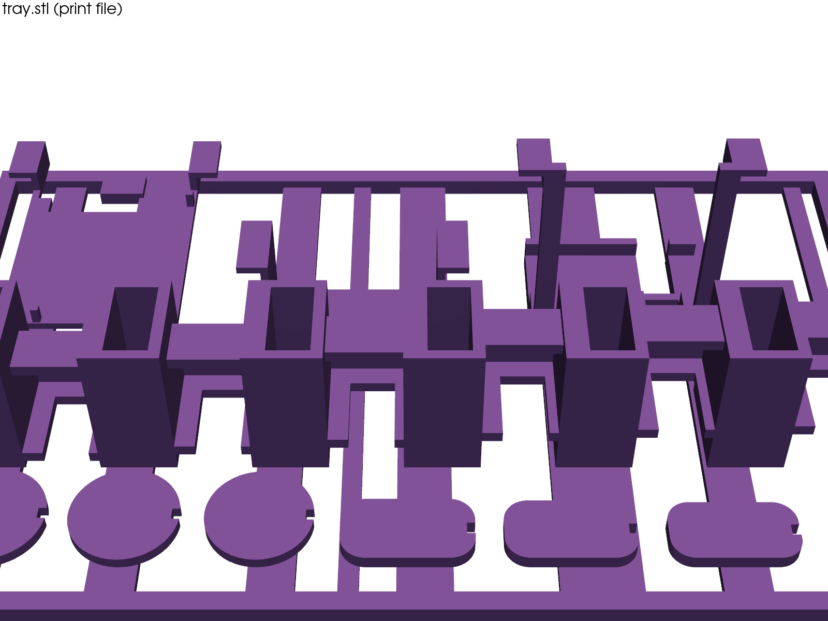
out/img/print_tray.png
