eee62/pbthing/out/sim/render/fail_hold6_events_all_steps.png

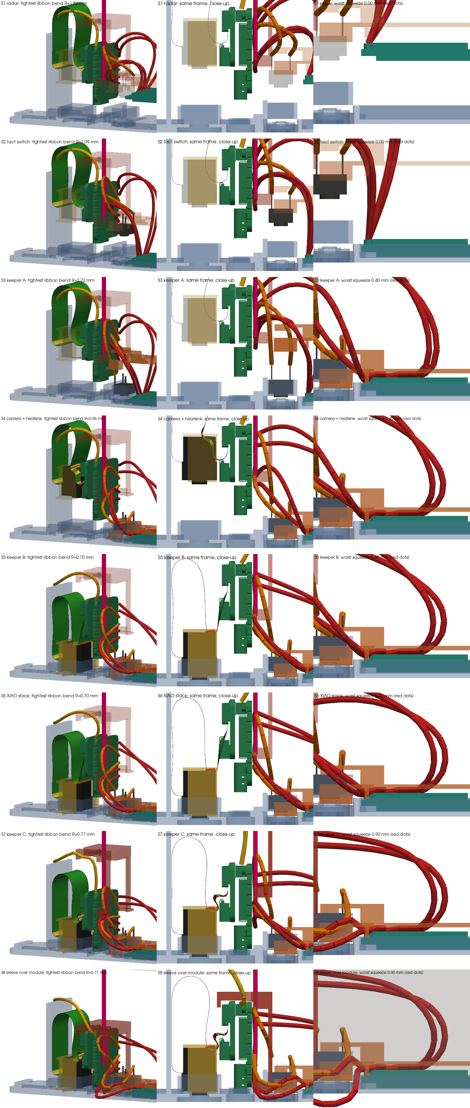
out/sim/render/fail_hold6_events_all_steps.png
