eee62/pbthing/out/sim/render/fail_hold6_video/step_S1_radar.png

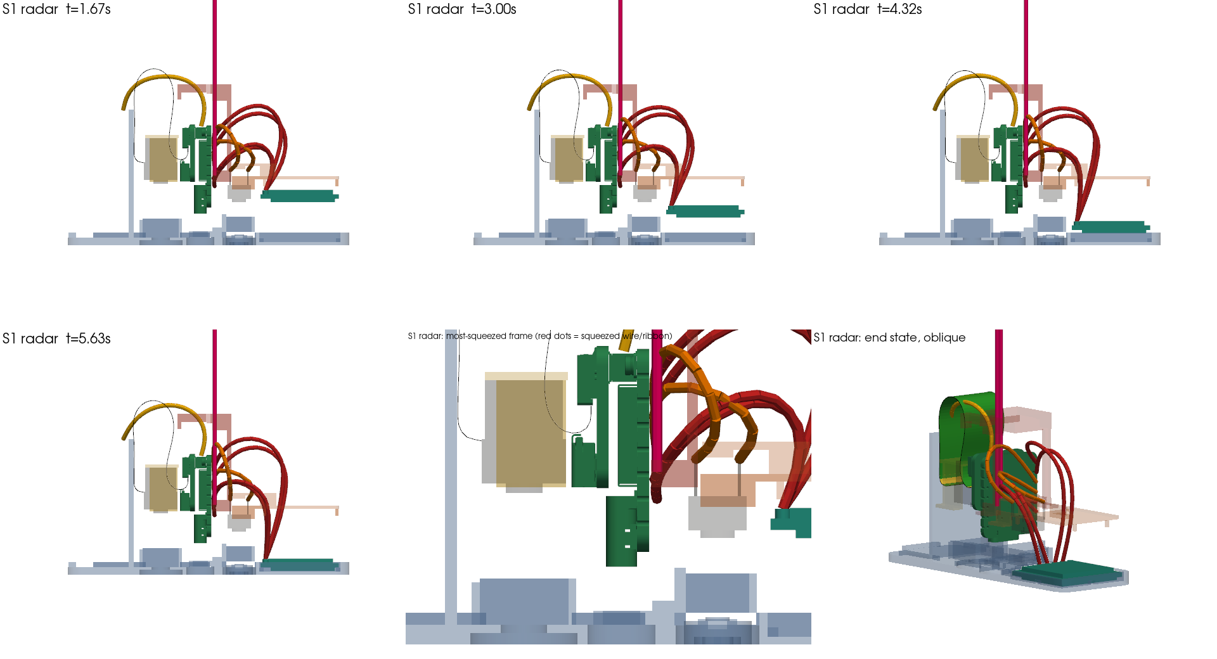
out/sim/render/fail_hold6_video/step_S1_radar.png
