eee62/pbthing/out/sim/render/fail_hold6_video/step_S5_keeper_B.png

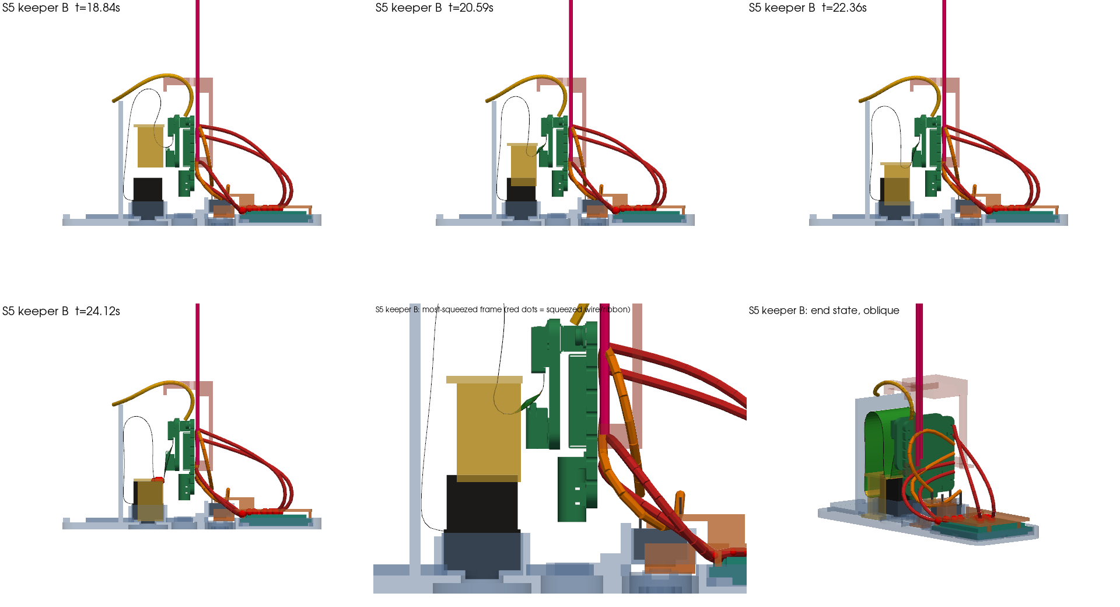
out/sim/render/fail_hold6_video/step_S5_keeper_B.png
