eee62/pbthing/out/sim/render/fail_hold6_video/step_S8_sleeve_over_module.png

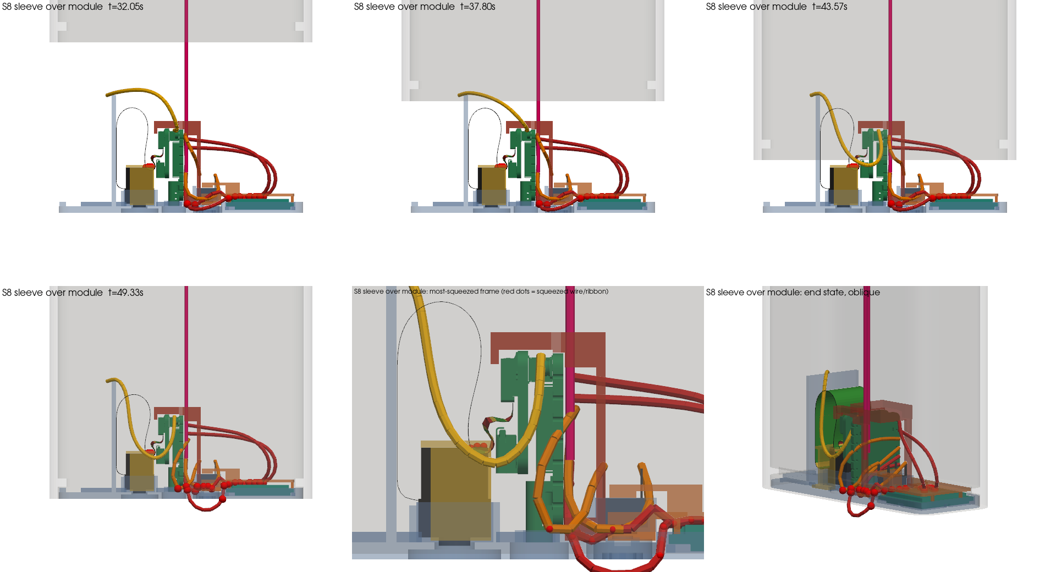
out/sim/render/fail_hold6_video/step_S8_sleeve_over_module.png
