eee62/pbthing/out/sim/render/final/step_S1_radar.png

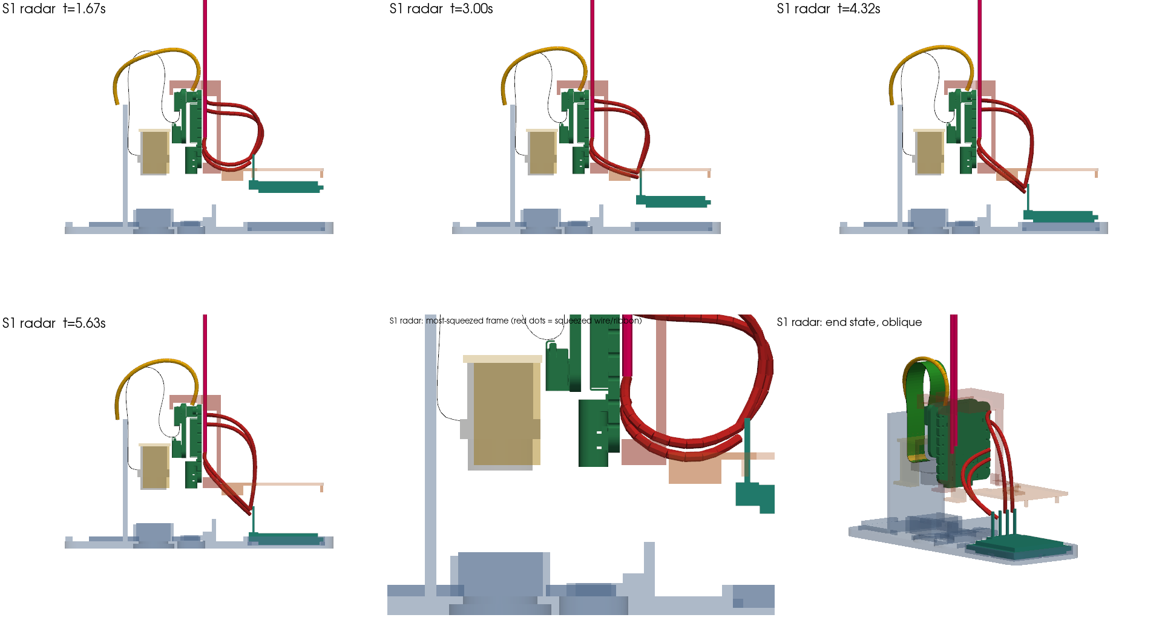
out/sim/render/final/step_S1_radar.png
