eee62/pbthing/out/sim/render/final/step_S4_camera__heatsink.png

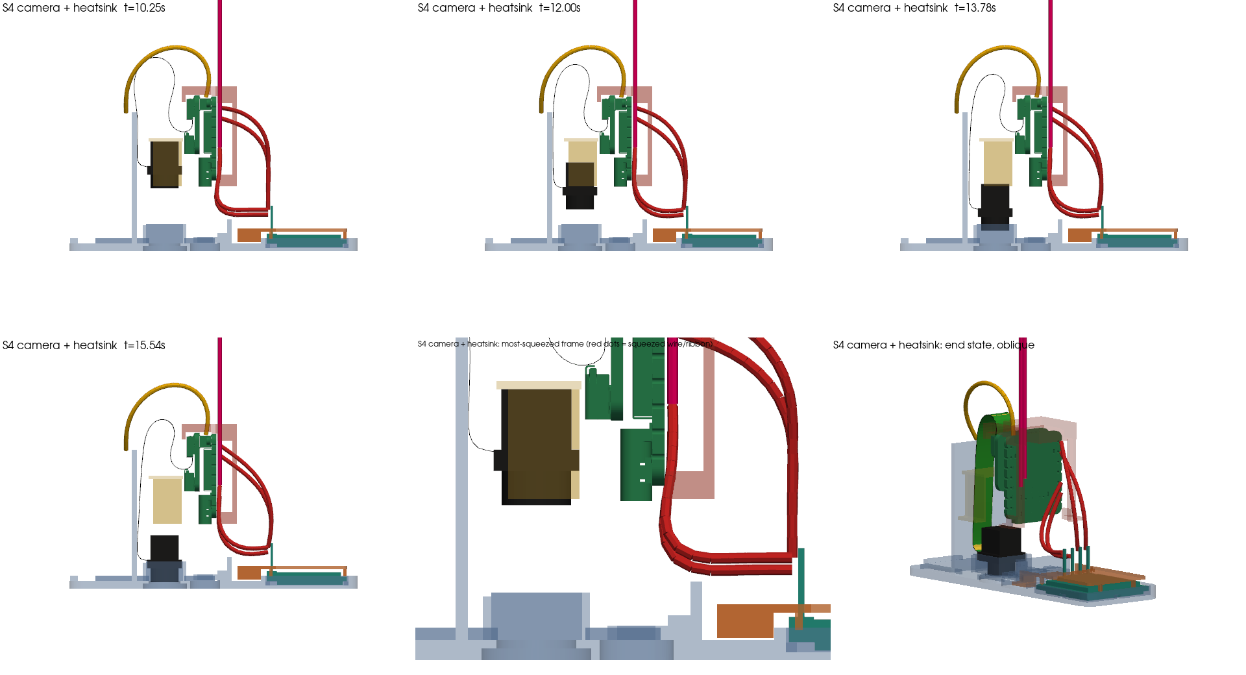
out/sim/render/final/step_S4_camera__heatsink.png
