eee62/pbthing/out/sim/render/final/step_S8_sleeve_over_module.png

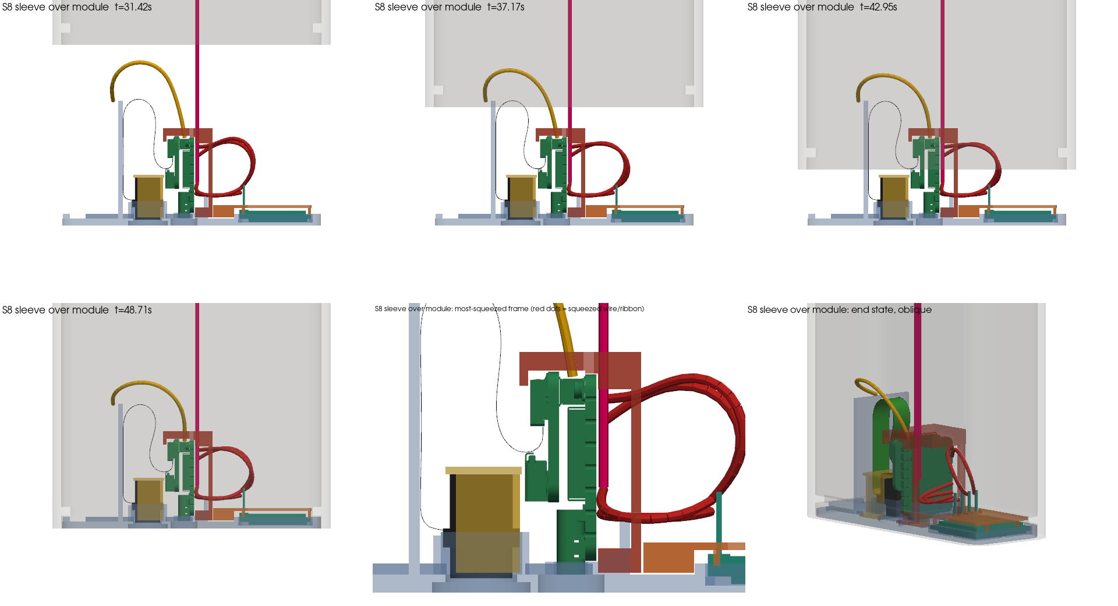
out/sim/render/final/step_S8_sleeve_over_module.png
