eee62/pbthing/out/sim/render/final_dress_events_all_steps.png

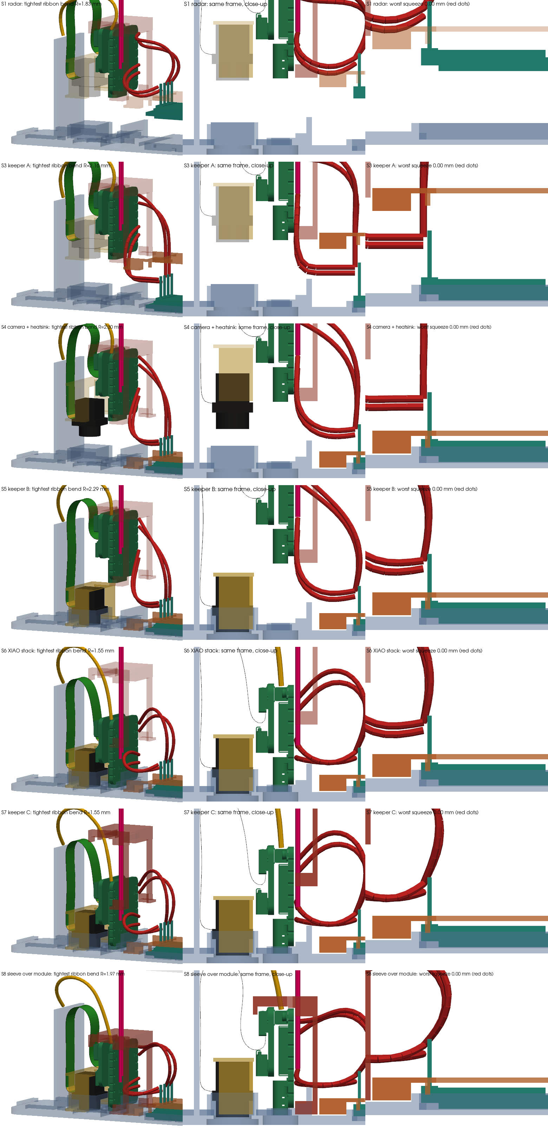
out/sim/render/final_dress_events_all_steps.png
