eee62/pbthing/(commit log)

2026-11-05 Add zen_v7 sleeve insert, plug, keepers, coupon and verification
    Parametric CadQuery design for the hidden-sensor power-bank enclosure:
    one-piece faceplate/tray insert, flush bottom plug with latching-switch
    carriers (H 10-14), three keepers, caps/covers A/B/C on one tray, and a
    fit coupon cut from the production geometry. verify.py checks solids,
    exact-boolean interference, swept install paths, wall thickness,
    tolerances, wire/FPC sweeps, switch recesses and the button icon
    (111 checks, 0 failures). REPORT.md and ASSEMBLY.md document decisions,
    assumptions, risks and the assembly order.
    Claude-Session: https://claude.ai/code/session_0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
    [XIAO_ESP32S3_ExpBoard_v1.0_bot.dxf, XIAO_ESP32S3_ExpBoard_v1.0_top.dxf, XIAO_ESP32S3_Sense.step, carrier_H10.stl, carrier_H11.stl, carrier_H12.stl, carrier_H13.5.stl, carrier_H13.stl]
2026-11-05 Add JST-PH plug zone, move antenna, add connector/Wi-Fi/permanent-build review
    - JST-PH 2-pin pair (real mated size 5.9 x 4.5 x 11.4 mm, from the JST PH
    catalog) in a printed cage on the plug (plug zone P1, -y end column);
    battery harness rerouted through it. Optional red RCY splice
    (23.3 x 4.0 mm) via PB_RCY=1; length cost reported.
    - Antenna moved to a new +y end wall of the insert: 13.3 mm from the camera
    ribbon (was 1.8), 15.4 mm from the camera head (was 3.9).
    - verify.py section 10: zone keep-out, end-column clearance, length cost,
    Wi-Fi distances, heat proximity, free volume. 123 checks / 0 failures
    (125 / 0 with the RCY splice).
    - New REVIEW_CONNECTORS_WIFI_SEAL.md; READM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
    [insert.step, insert.stl, keeper_a.step, keeper_b.step, keeper_c.step, plug.step, plug.stl]
2026-11-05 Revert "Add JST-PH plug zone, move antenna, add connector/Wi-Fi/permanent-build review"
    Undo requested by the user; replaced by the OV5640 camera update and
    physical assembly simulation work.
    Claude-Session: https://claude.ai/code/session_01MdsTejsK43CkGzKv3tZiXP
    [insert.step, insert.stl, keeper_a.step, keeper_b.step, keeper_c.step, plug.step, plug.stl]
2026-11-05 OV5640 update (lens D3.8, base 8.65, 5.6 base-to-lens, heatsink to 11.7 mm), new ribbon route, assembly-simulation engine (WIP)
    - camera model, ribbon route (no pinch, r >= 2 mm) and keeper B/FPC geometry updated; numeric verify re-run
    - src/sim: exact-SDF rigid-body + flexible ribbon/wire simulator, scenario, renderer, radar-behind-window study
    - keeper B gets an optional ribbon slot (off by default; the simulation shows it is not needed when the XIAO is held aside)
    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
    [coupon.stl, insert.step, insert.stl, keeper_a.step, keeper_b.step, keeper_b.stl, keeper_c.step, plug.step]
2026-11-05 Sim: Coulomb friction fix, lead/coax service slack, framed render views, radar renders (WIP)
    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
2026-11-05 Sim: speed test, event renderer, A2/F/G/H runs and 6 mm hold-off failure renders (WIP)
    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
2026-11-05 Rebuild + verify (0 failed), REPORT: correct 9000HE permittivity and radar-gap statement, slow-run logs (WIP)
    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
    [insert.step, keeper_a.step, keeper_b.step, keeper_c.step, plug.step]
2026-11-05 Sim: slow quasi-static runs (hold-off 6/25 mm), wire-dressing option, tracker fix, design renders regenerated for the new camera
    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
2026-11-05 Sim: hold-off 14 mm candidate runs (WIP)
    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
2026-11-05 SIMULATION.md draft, ASSEMBLY/README updates, final-run renders (WIP)
    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
2026-11-05 Assembly simulation results, radar-at-6.2 mm study, doc updates, videos
    - SIMULATION.md: method, limits, per-step results, failure case (XIAO held 6 mm aside), radar options and blocking dimension
    - ASSEMBLY.md: hold the XIAO >= 12 mm aside until keeper B, dress wires before keepers A/C and the sleeve, 16-22 mm slack
    - REPORT.md/README.md updated; 9000HE permittivity corrected; design renders regenerated
    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
2026-11-05 Camera heatsink 7.0 x 7.1 x 6.0 (+0.1 pad, total 11.7), centred on the base; rebuild (WIP: verification and re-simulation running)
    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
    [insert.step, keeper_a.step, keeper_b.step, keeper_c.step, plug.step]
2026-11-05 Verification re-run with the 7.0 x 7.1 x 6.0 heatsink: 111 PASS, 0 FAIL; hold-off test driver (WIP)
    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
2026-11-05 Hold-off scan with the 7.0 x 7.1 x 6.0 heatsink (6/10/11/12.5 mm), full-run logs (WIP)
    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
2026-11-05 Heatsink 7.0 x 7.1 x 6.0: re-simulation (S4/S6, hold-off scan), SIMULATION/ASSEMBLY/REPORT updated (re-rendered video pending)
    - final procedure identical to the 8x8x6.1 run (heatsink never near the ribbon at 14 mm hold-off)
    - hold-off: keeper B floor underside (z 126.4), not the heatsink, sets the minimum: 12.1 mm (11 mm fails, 12.5 clean); was 11.7
    - S6 ribbon dip 1.56 mm unchanged
    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
2026-11-05 Re-rendered key frames and event close-ups with the new heatsink (video pending)
    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
2026-11-05 Re-rendered assembly video with the 7.0 x 7.1 x 6.0 heatsink
    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
2026-11-07 Camera: barrel O7 x 3.45, lens-holder block 1.75, front glass O3.5, ribbon 6 mm, faceplate lens hole O7.6 (WIP, re-simulation running)
    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
    [coupon.stl, insert.step, insert.stl, keeper_a.step, keeper_b.step, keeper_c.step, plug.step]
2026-11-07 Camera O7 barrel update: re-simulation, SIMULATION/REPORT/ASSEMBLY updated (renders may still be updating)
    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
2026-11-07 Re-rendered frames and video with the O7 barrel camera
    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
2026-11-07 Lens hole O8.0, USB-C pocket 13.3 x 7.4 (verify 114 PASS), header study (no design change), docs (WIP: simulation running)
    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
    [coupon.stl, insert.step, insert.stl, keeper_a.step, keeper_b.step, keeper_c.step, plug.step, tray.stl]
2026-11-07 Simulation re-run for lens hole O8.0 / USB-C pocket 13.3 x 7.4: no change
    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
2026-11-07 Radar header kept: pin 1 clipped, plastic trimmed, wires soldered to pin tips; HDR_* parameters; verify 118 PASS (WIP: simulation running)
    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
    [insert.step, keeper_a.step, keeper_b.step, keeper_c.step, plug.step]
2026-11-07 Re-rendered frames with the radar header (video may follow)
    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
2026-11-07 Re-rendered assembly video with the radar header
    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
2026-11-08 Four input changes: holder 62x76x20, 24 AWG battery path, 1S protection board, front tact switch/button/icon removed; coupon/tray rebuilt; verify 0 failed (WIP: simulation running)
    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
    [coupon.stl, insert.step, insert.stl, keeper_a.step, keeper_a.stl, keeper_b.step, keeper_c.step, plug.step]
2026-11-08 Simulation re-run without the front tact switch: all wire squeezes 0.00, S6 ribbon dip 1.55 unchanged
    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
2026-11-08 Re-rendered frames (no tact switch)
    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
2026-11-08 Re-rendered assembly video without the front tact switch
    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
